nathanshaw/Moth/README.md

# Speculator
This repo holds all the code, schematics, and PCB layouts for all series of the Speculator bot.
