nathanshaw/Moth/PCB/v2/v2_images/v2_both_no_pour.pdf

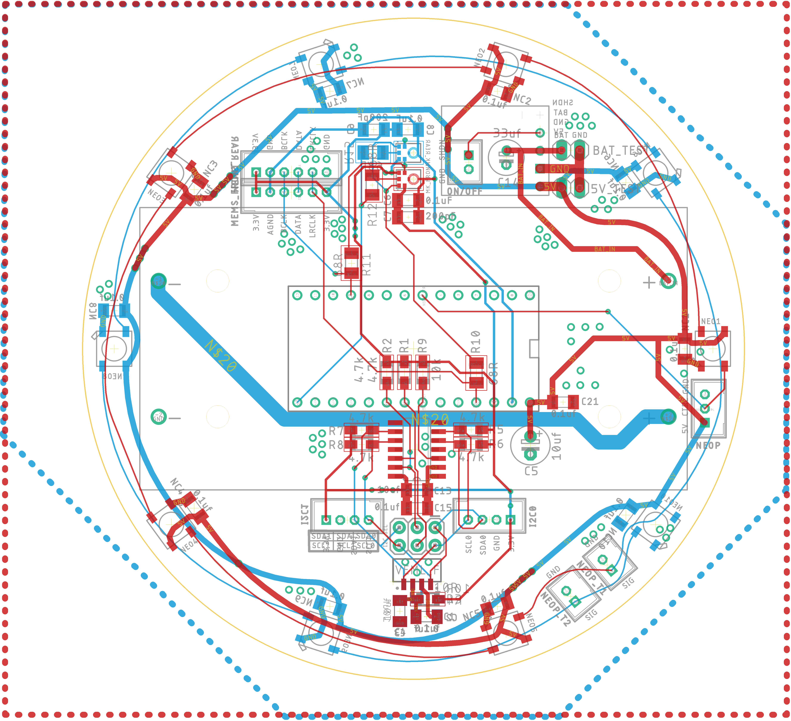
[picture p1: page 1]
