nathanshaw/Moth/PCB/v2/v2_images/v2_both_with_pour.pdf

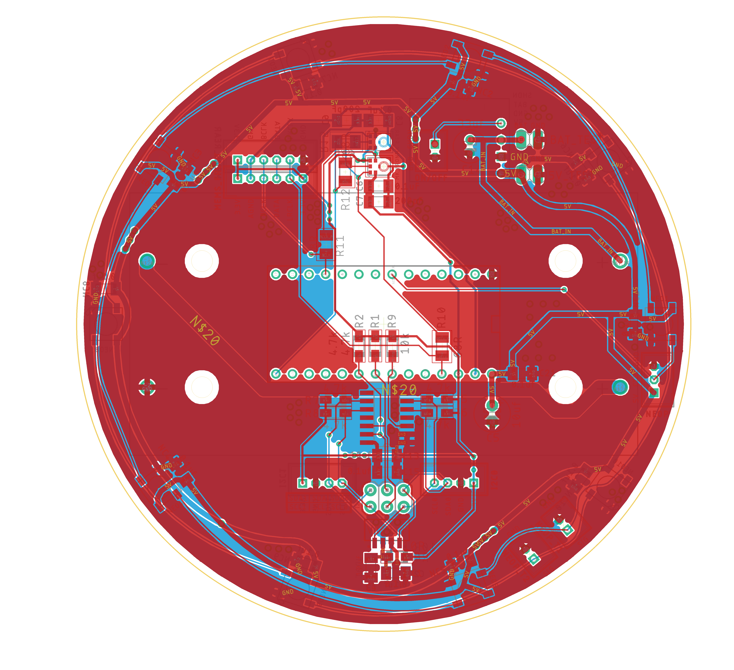
[picture p2: page 1]
