nathanshaw/Moth/PCB/v2/v2_images/v2_bottom_no_pour.pdf

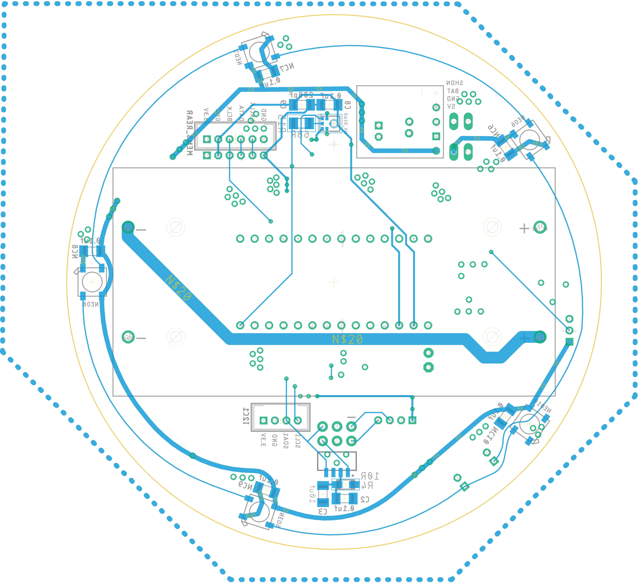
[picture p3: page 1]
