nathanshaw/Moth/PCB/v2/v2_images/v2_bottom_with_pour.pdf

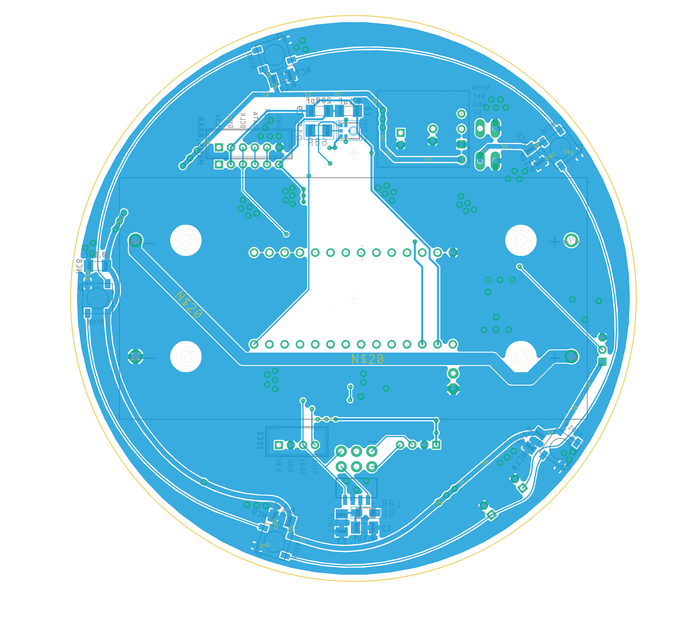
[picture p4: page 1]
