nathanshaw/Moth/PCB/v2/v2_images/v2_top_no_pour.pdf

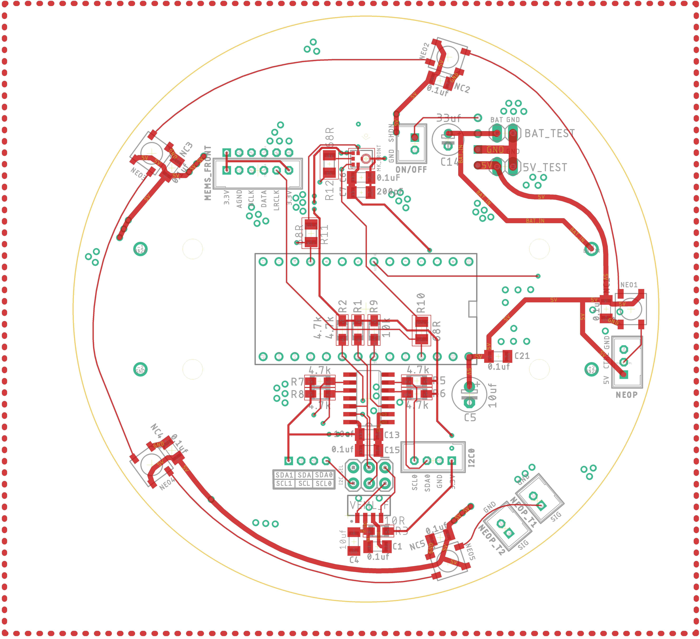
[picture p5: page 1]
