nathanshaw/Moth/PCB/v2/v2_images/v2_top_with_pour.pdf

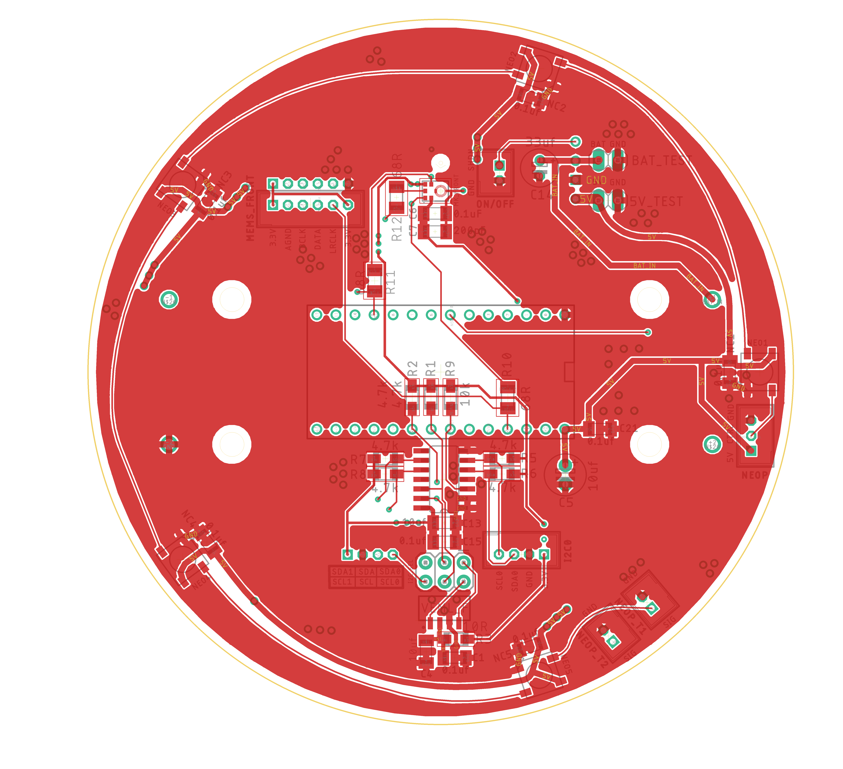
[picture p6: page 1]
