nathanshaw/Moth/PCB/v2_1/v2_1_images/v2_1_both_no_pour.pdf

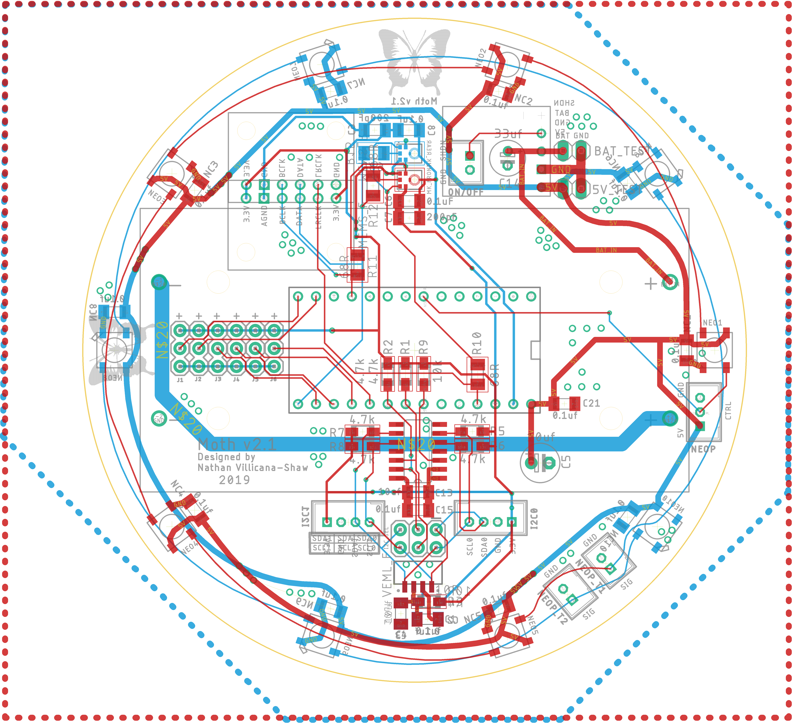
[picture p7: page 1]
