nathanshaw/Moth/PCB/v2_1/v2_1_images/v2_1_both_with_pour.pdf

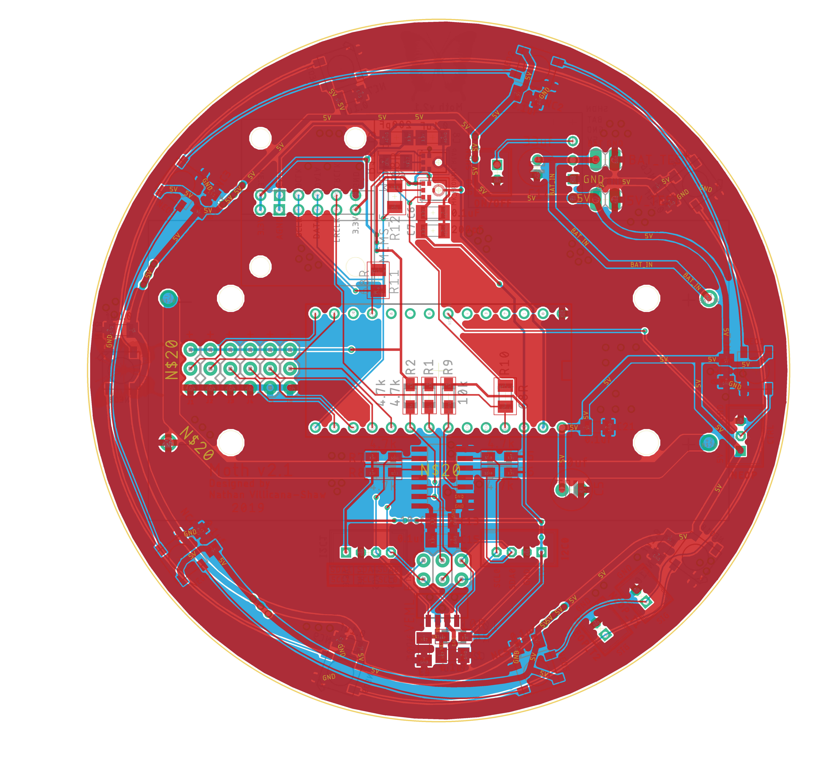
[picture p8: page 1]
