nathanshaw/Moth/PCB/v2_1/v2_1_images/v2_1_bottom_no_pour.pdf

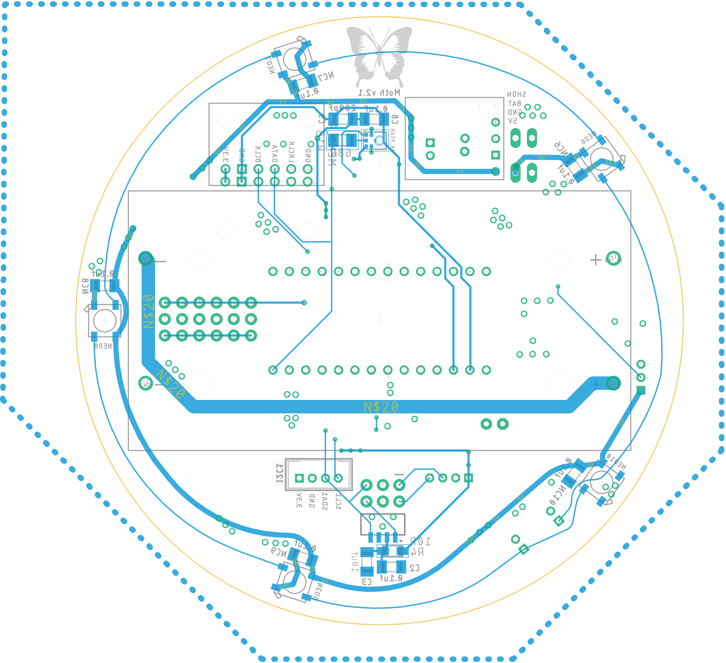
[picture p9: page 1]
