nathanshaw/Moth/PCB/v2_1/v2_1_images/v2_1_bottom_with_pour.pdf

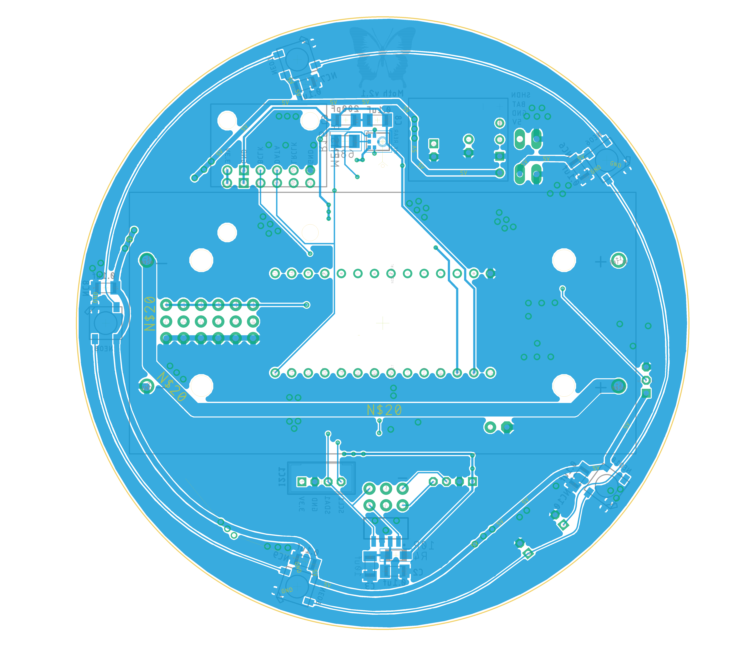
[picture p10: page 1]
