nathanshaw/Moth/PCB/v2_1/v2_1_images/v2_1_top_with_pour.pdf

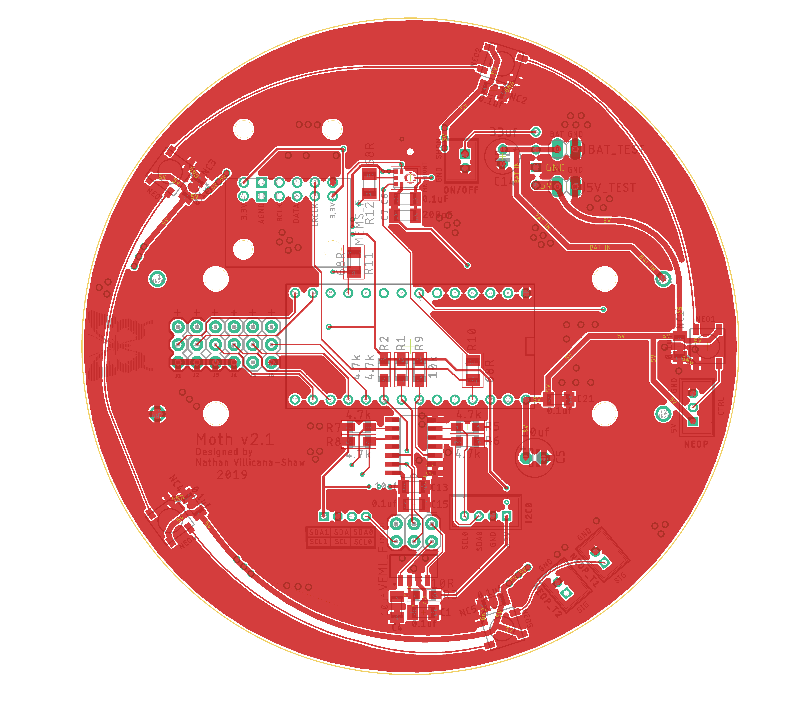
[picture p11: page 1]
