nathanshaw/Moth/PCB/v3/images/54mm/moth_v3_54mm_rear_with_pour.png

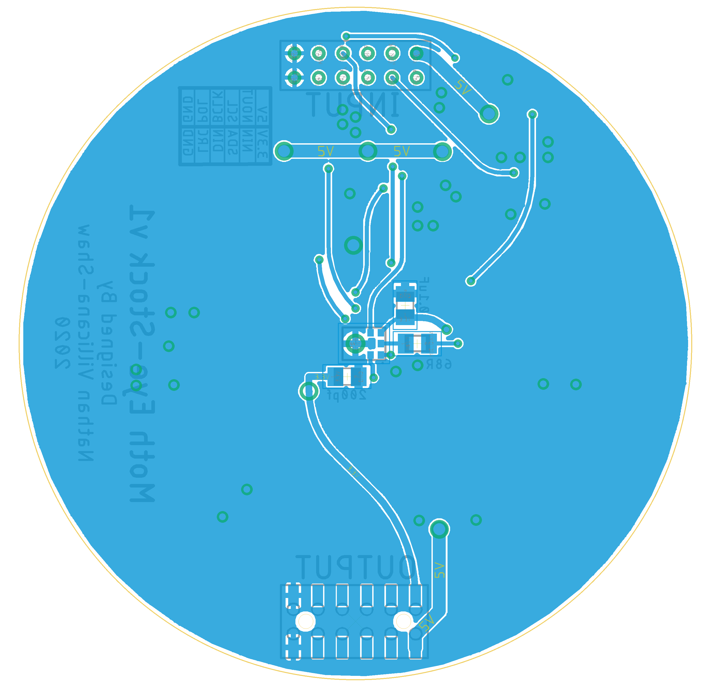
PCB/v3/images/54mm/moth_v3_54mm_rear_with_pour.png
