nathanshaw/Moth/PCB/v3/images/80mm/moth_v3_80mm_both_with_pour.png

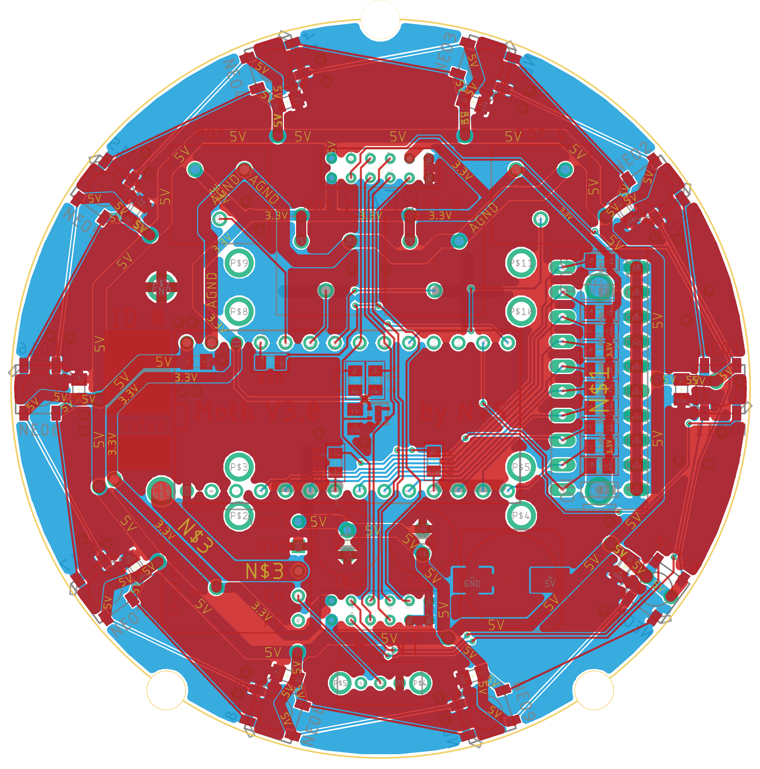
PCB/v3/images/80mm/moth_v3_80mm_both_with_pour.png
