nathanshaw/Moth/PCB/v3/images/80mm/moth_v3_80mm_top_no_pour.png

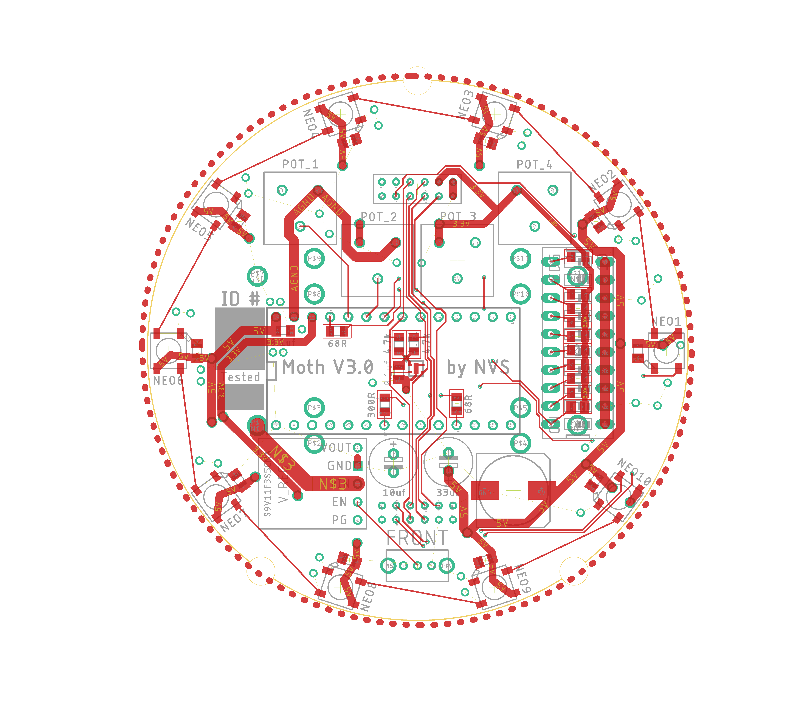
PCB/v3/images/80mm/moth_v3_80mm_top_no_pour.png
