nathanshaw/Moth/PCB/v2_1/moth_v2.1.brd

## EAGLE design PCB/v2_1/moth_v2.1.brd (2020-09-16, an earlier design)

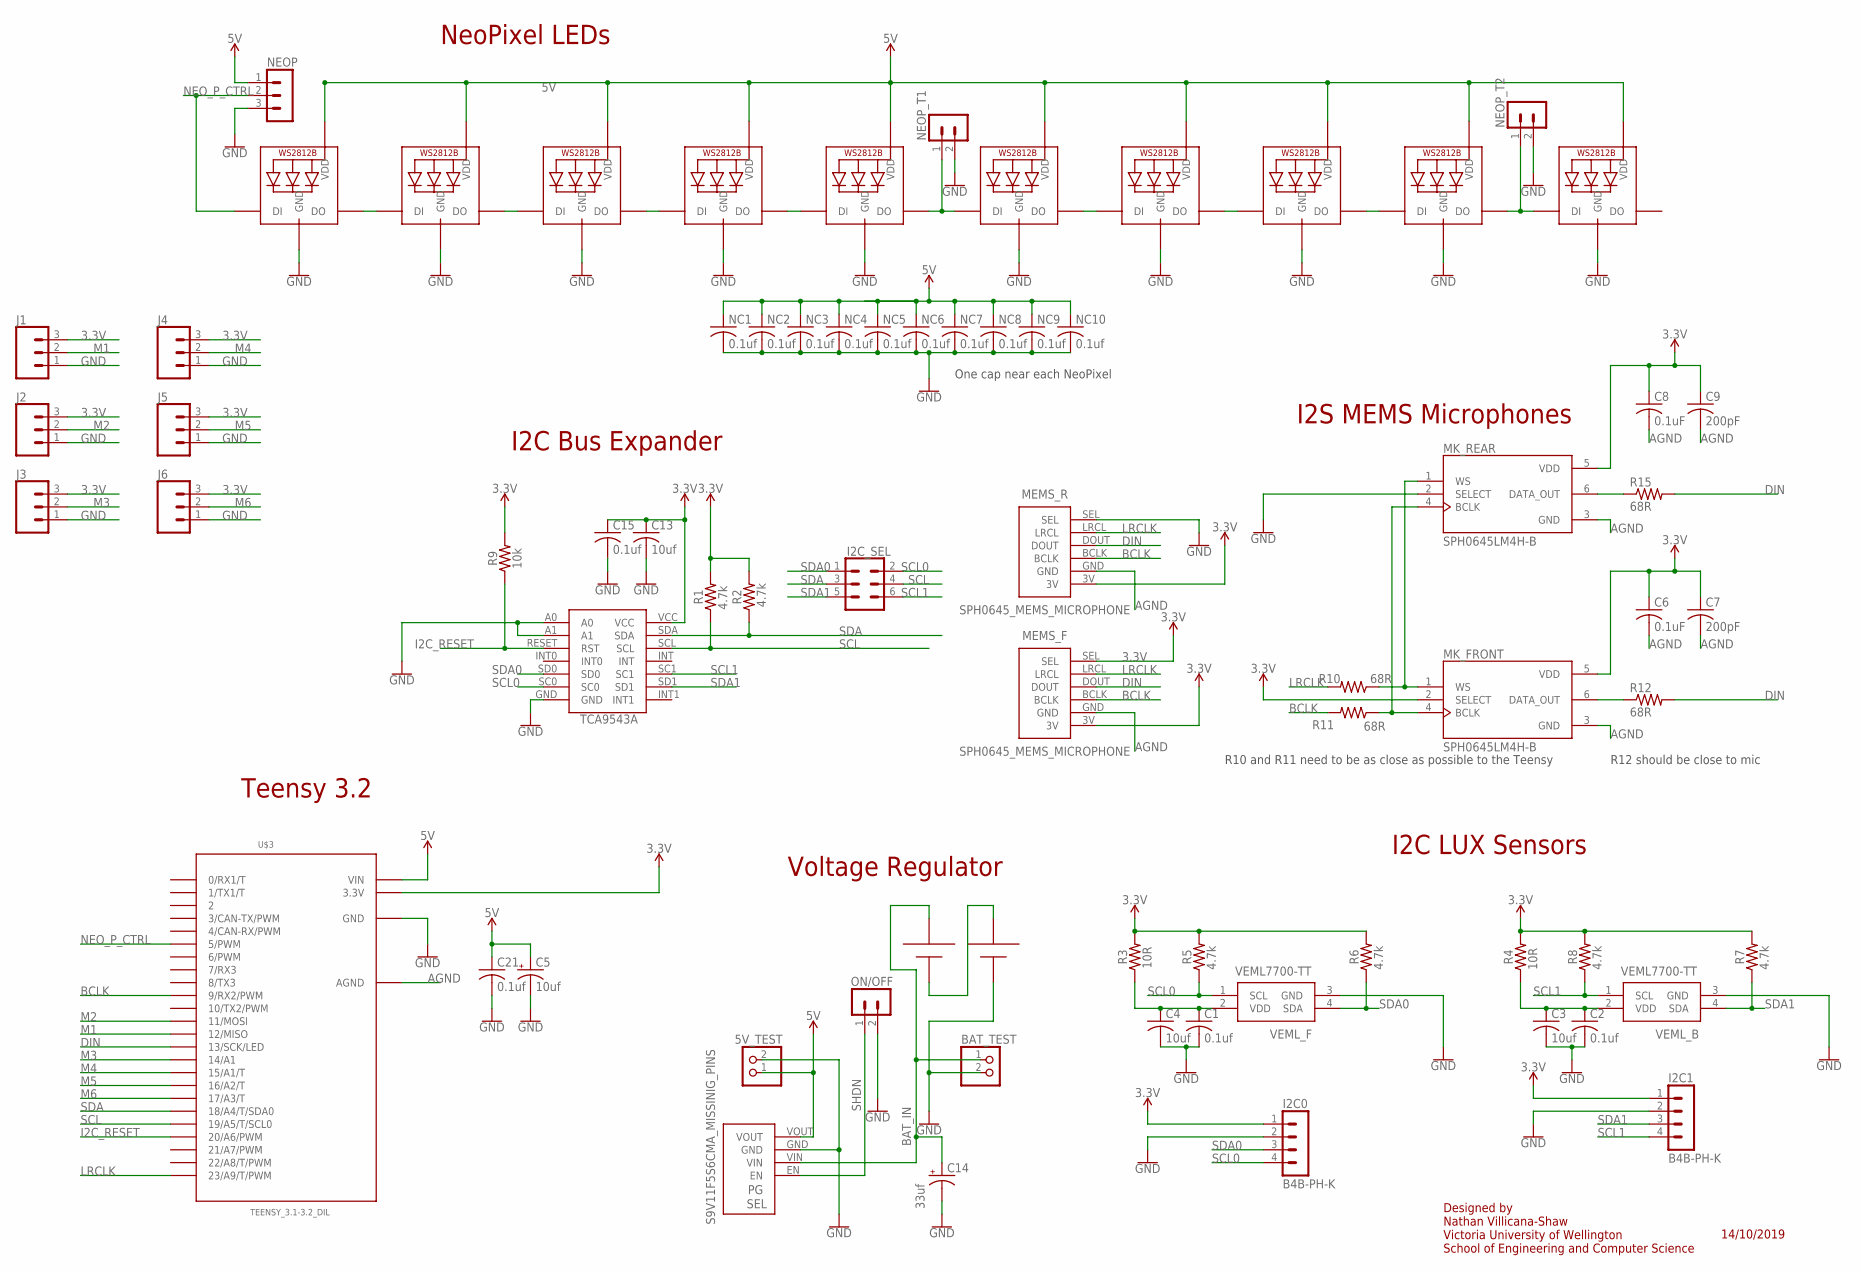
[picture p23: schematic moth_v2.1.sch]

Parts:
5V_TEST: PINHD-1X2; 1X02
BAT_TEST: PINHD-1X2; 1X02
C1, C2, C15, C21: 0.1uf; C1206K
C3, C4, C13: 10uf; C1206K
C5: 10uf; E2,5-6
C6, C8: 0.1uF; C1206K
C7, C9: 200pF; C1206K
C14: 33uf; E2-5
I2C0, I2C1: B4B-PH-K
I2C_SEL: FEMALE 2x3; 2X3
J1, J2, J3, J4, J5, J6: CONN_03; 1X03
MEMS_F: SPH0645_MEMS_MICROPHONE; SPH0645
MEMS_R: SPH0645_MEMS_MICROPHONE; SPH0645
MK_FRONT: SPH0645LM4H-B; MIC_SPH0645LM4H-B
MK_REAR: SPH0645LM4H-B; MIC_SPH0645LM4H-B
NC1, NC2, NC3, NC4, NC5, NC6, NC7, NC8, NC9, NC10: 0.1uf; C1206K
NEO1, NEO2, NEO3, NEO4, NEO5, NEO6, NEO7, NEO8, NEO9, NEO10: WS2812B5050; WS2812B
NEOP: B3B-PH-K
NEOP_T1, NEOP_T2: B2B-PH-K
ON/OFF: B2B-PH-K
R1, R2, R5, R6, R7, R8: 4.7k; R1206W
R3, R4: 10R; R1206W
R9: 10k; R1206W
R10, R11, R12, R15: 68R; M1206
U$1: TCA9543A; SO14
U$2: BK-18650-PC4; 18650-PC4
U$3: TEENSY_3.1-3.2_DIL; TEENSY_3.0-3.2&LC_DIL
U$6: S9V11F5S6CMA_MISSINIG_PINS; S9V11F3S5CMA_MISSING_PINS
VEML_B: VEML7700-TT; VEML7700
VEML_F: VEML7700-TT; VEML7700

Connections:
3.3V: C6.1, C7.1, C8.1, C9.1, C13.1, C15.1, I2C0.1, I2C1.1, J1.3, J2.3, J3.3, J4.3, J5.3, J6.3, MEMS_F.3V, MEMS_F.SEL, MEMS_R.3V, MK_FRONT.2 (SELECT), MK_FRONT.5 (VDD), MK_REAR.5 (VDD), R1.2, R2.2, R3.2, R4.2, R5.2, R6.2, R7.2, R8.2, R9.2, U$1.VCC, U$3.3.3V
5V: 5V_TEST.1, C5.+, C21.1, NC1.1, NC2.1, NC3.1, NC4.1, NC5.1, NC6.1, NC7.1, NC8.1, NC9.1, NC10.1, NEO1.1-VDD (VDD), NEO2.1-VDD (VDD), NEO3.1-VDD (VDD), NEO4.1-VDD (VDD), NEO5.1-VDD (VDD), NEO6.1-VDD (VDD), NEO7.1-VDD (VDD), NEO8.1-VDD (VDD), NEO9.1-VDD (VDD), NEO10.1-VDD (VDD), NEOP.1, U$3.VIN, U$6.VOUT
AGND: C6.2, C7.2, C8.2, C9.2, MEMS_F.GND, MEMS_R.GND, MK_FRONT.3 (GND), MK_REAR.3 (GND), U$3.AGND
BAT_IN: BAT_TEST.1, C14.+, U$2.+1, U$6.VIN
BCLK: MEMS_F.BCLK, MEMS_R.BCLK, R11.2, U$3.9 (9/RX2/PWM)
BCLK_P: MK_FRONT.4 (BCLK), MK_REAR.4 (BCLK), R11.1
DIN: MEMS_F.DOUT, MEMS_R.DOUT, R12.2, R15.2, U$3.13 (13/SCK/LED)
GND: 5V_TEST.2, BAT_TEST.2, C1.2, C2.2, C3.2, C4.2, C5.-, C13.2, C14.-, C15.2, C21.2, I2C0.2, I2C1.2, J1.1, J2.1, J3.1, J4.1, J5.1, J6.1, MEMS_R.SEL, MK_REAR.2 (SELECT), NC1.2, NC2.2, NC3.2, NC4.2, NC5.2, NC6.2, NC7.2, NC8.2, NC9.2, NC10.2, NEO1.3-GND (GND), NEO2.3-GND (GND), NEO3.3-GND (GND), NEO4.3-GND (GND), NEO5.3-GND (GND), NEO6.3-GND (GND), NEO7.3-GND (GND), NEO8.3-GND (GND), NEO9.3-GND (GND), NEO10.3-GND (GND), NEOP.3, NEOP_T1.2, NEOP_T2.2, ON/OFF.2, U$1.A0, U$1.A1, U$1.GND, U$2.-2, U$3.GND, U$6.GND, VEML_B.3 (GND), VEML_F.3 (GND)
I2C_RESET: R9.1, U$1.RESET (RST), U$3.20/A6 (20/A6/PWM)
LRCLK: MEMS_F.LRCL, MEMS_R.LRCL, R10.2, U$3.23/A9 (23/A9/T/PWM)
LRCLK_P: MK_FRONT.1 (WS), MK_REAR.1 (WS), R10.1
M1: J1.2, U$3.12 (12/MISO)
M2: J2.2, U$3.11 (11/MOSI)
M3: J3.2, U$3.14/A0 (14/A1)
M4: J4.2, U$3.15/A1 (15/A1/T)
M5: J5.2, U$3.16/A2 (16/A2/T)
M6: J6.2, U$3.17/A3 (17/A3/T)
unnamed: C1.1, C4.1, R3.1, VEML_F.2 (VDD)
unnamed: C2.1, C3.1, R4.1, VEML_B.2 (VDD)
unnamed: MK_FRONT.6 (DATA_OUT), R12.1
unnamed: NEO2.2-DOUT (DO), NEO3.4-DIN (DI)
unnamed: NEO5.2-DOUT (DO), NEO6.4-DIN (DI), NEOP_T1.1
unnamed: NEO9.2-DOUT (DO), NEO10.4-DIN (DI), NEOP_T2.1
unnamed: NEO4.2-DOUT (DO), NEO5.4-DIN (DI)
unnamed: NEO3.2-DOUT (DO), NEO4.4-DIN (DI)
unnamed: NEO7.2-DOUT (DO), NEO8.4-DIN (DI)
unnamed: NEO8.2-DOUT (DO), NEO9.4-DIN (DI)
unnamed: MK_REAR.6 (DATA_OUT), R15.1
unnamed: U$2.+2, U$2.-1
unnamed: NEO6.2-DOUT (DO), NEO7.4-DIN (DI)
NEO_P1: NEO1.2-DOUT (DO), NEO2.4-DIN (DI)
NEO_P_CTRL: NEO1.4-DIN (DI), NEOP.2, U$3.5 (5/PWM)
SCL: I2C_SEL.4, R1.1, U$1.SCL, U$3.19/A5 (19/A5/T/SCL0)
SCL0: I2C0.4, I2C_SEL.2, R5.1, U$1.SC0, VEML_F.1 (SCL)
SCL1: I2C1.4, I2C_SEL.6, R8.1, U$1.SC1, VEML_B.1 (SCL)
SDA: I2C_SEL.3, R2.1, U$1.SDA, U$3.18/A4 (18/A4/T/SDA0)
SDA0: I2C0.3, I2C_SEL.1, R6.1, U$1.SD0, VEML_F.4 (SDA)
SDA1: I2C1.3, I2C_SEL.5, R7.1, U$1.SD1, VEML_B.4 (SDA)
SHDN: ON/OFF.1, U$6.EN

Notes on the sheet:
I2S MEMS Microphones
Voltage Regulator
I2C LUX Sensors
I2C Bus Expander
NeoPixel LEDs
10k
4.7k
One cap near each NeoPixel
R10 and R11 need to be as close as possible to the Teensy
R12 should be close to mic
10R
Teensy 3.2
Designed by Nathan Villicana-Shaw Victoria University of Wellington School of Engineering and Computer Science
14/10/2019

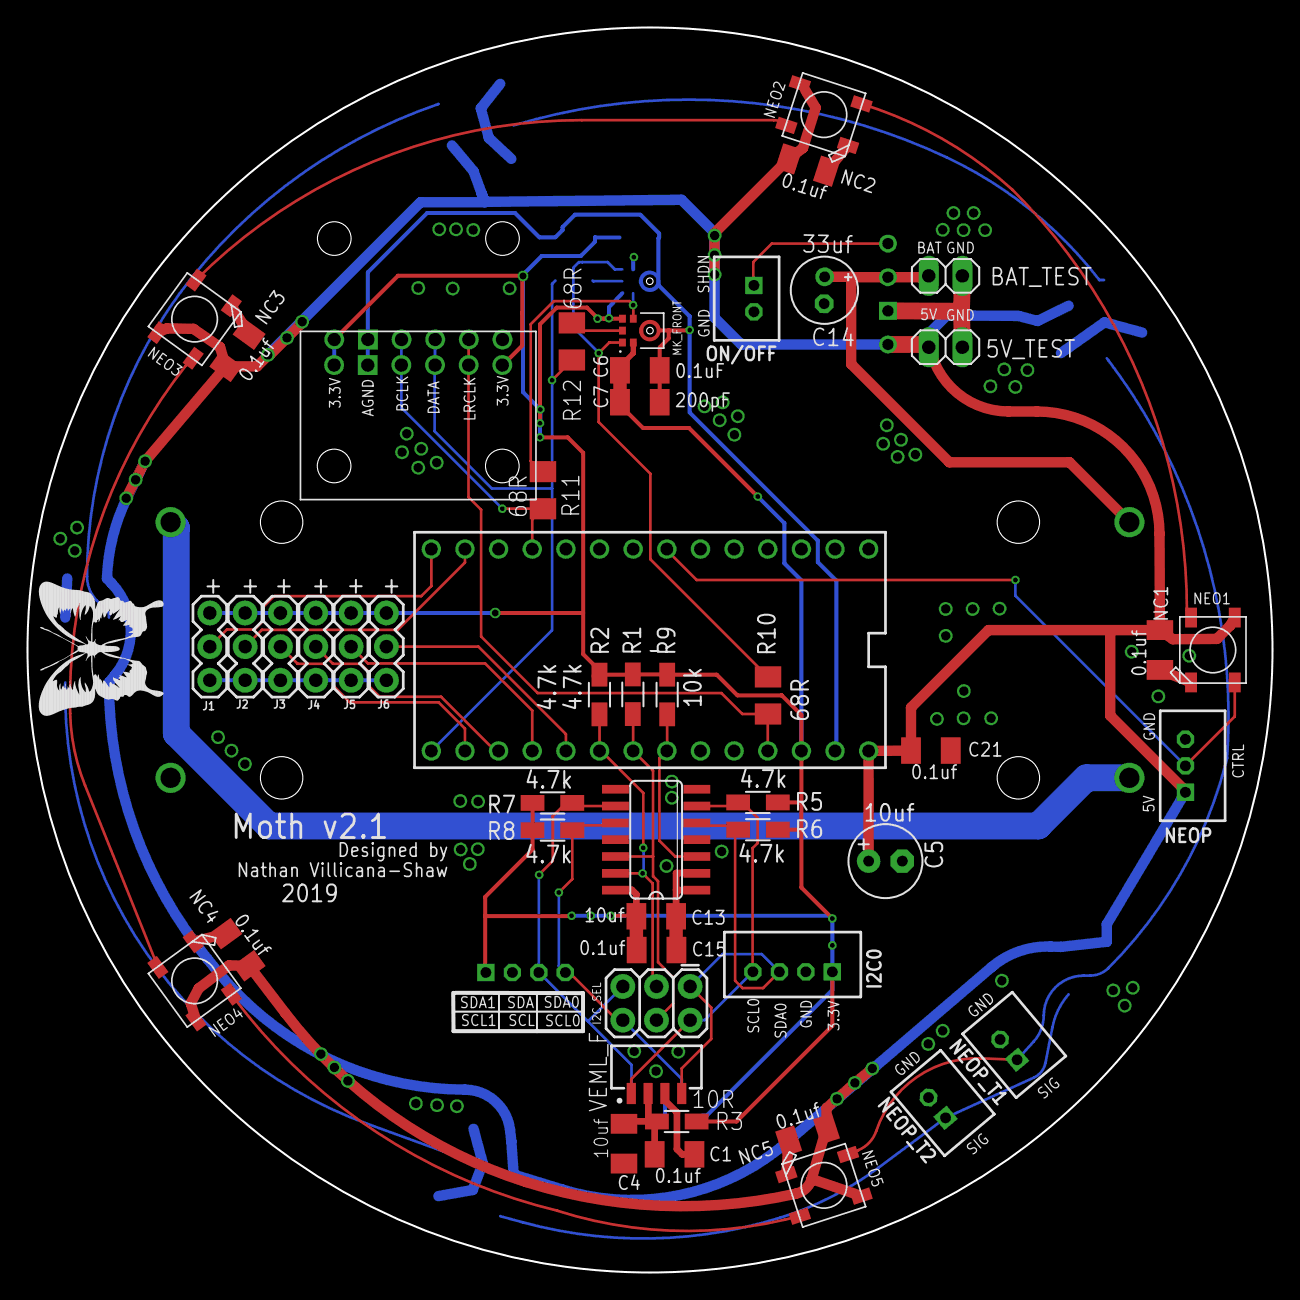
[picture p24: board moth_v2.1.brd from above]

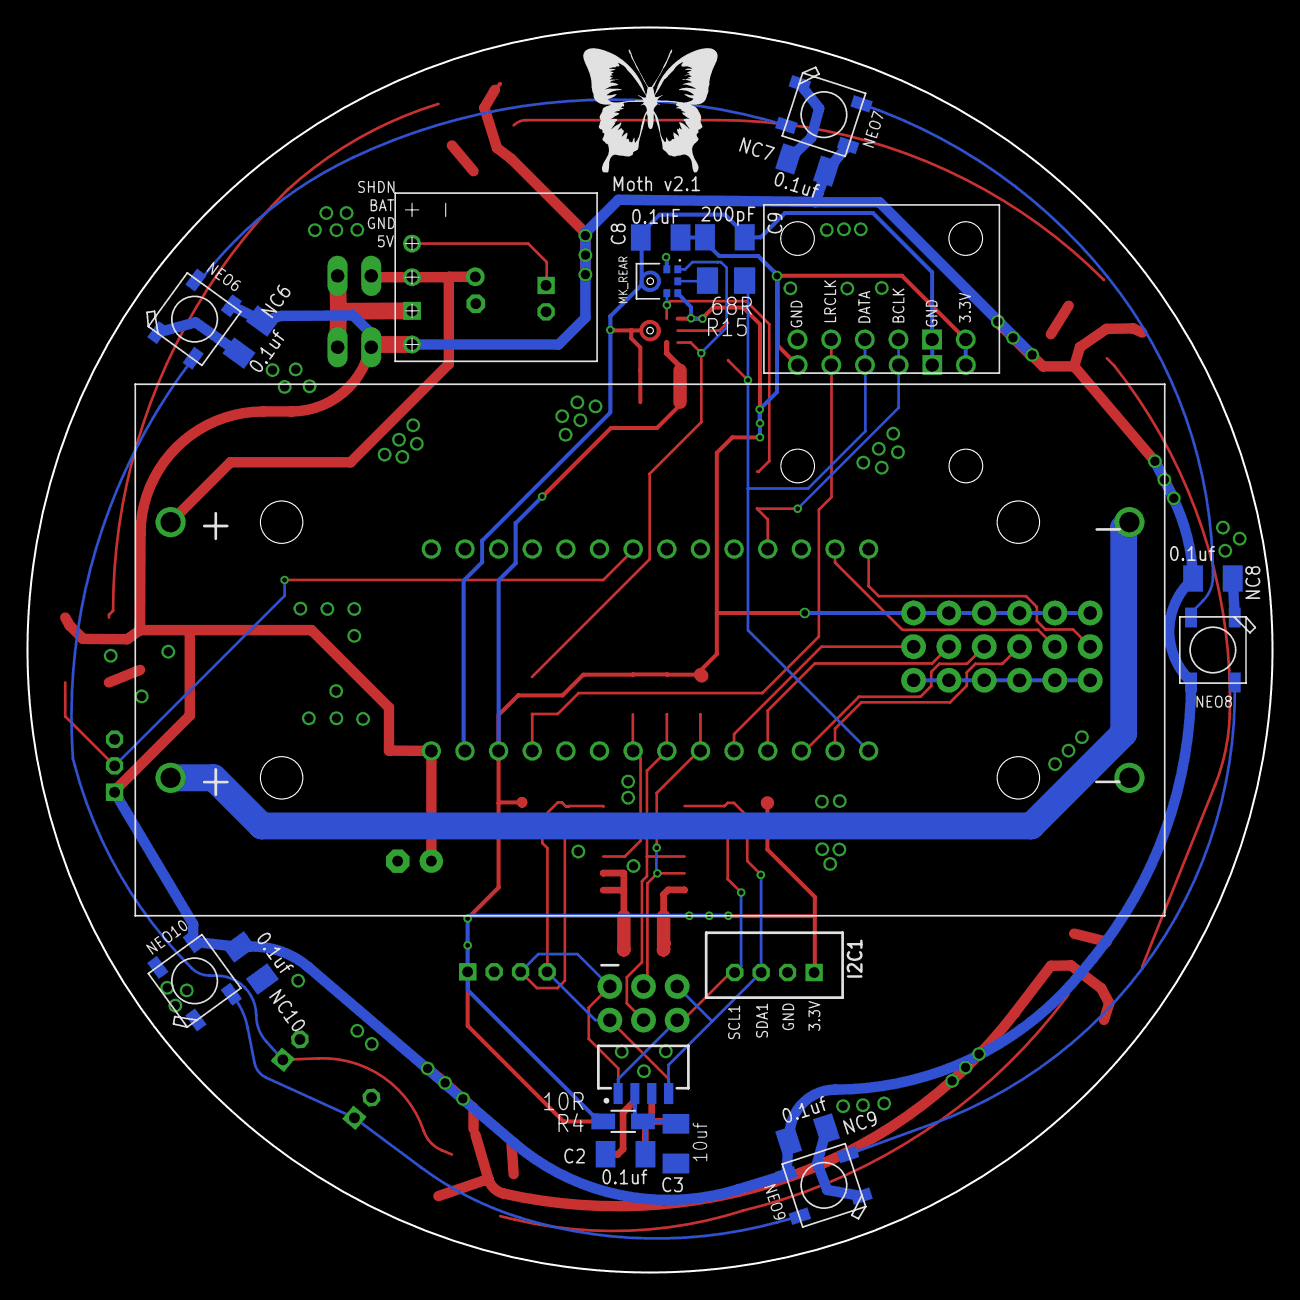
[picture p25: board moth_v2.1.brd from below]

Board: 2 copper layers, 94.0 x 94.0 mm, 71 parts (22 on the bottom side), 39 nets.
