nathanshaw/Moth/PCB/v3/moth_v3_80mm_main_board.brd

## EAGLE design PCB/v3/moth_v3_80mm_main_board.brd (2020-06-29)

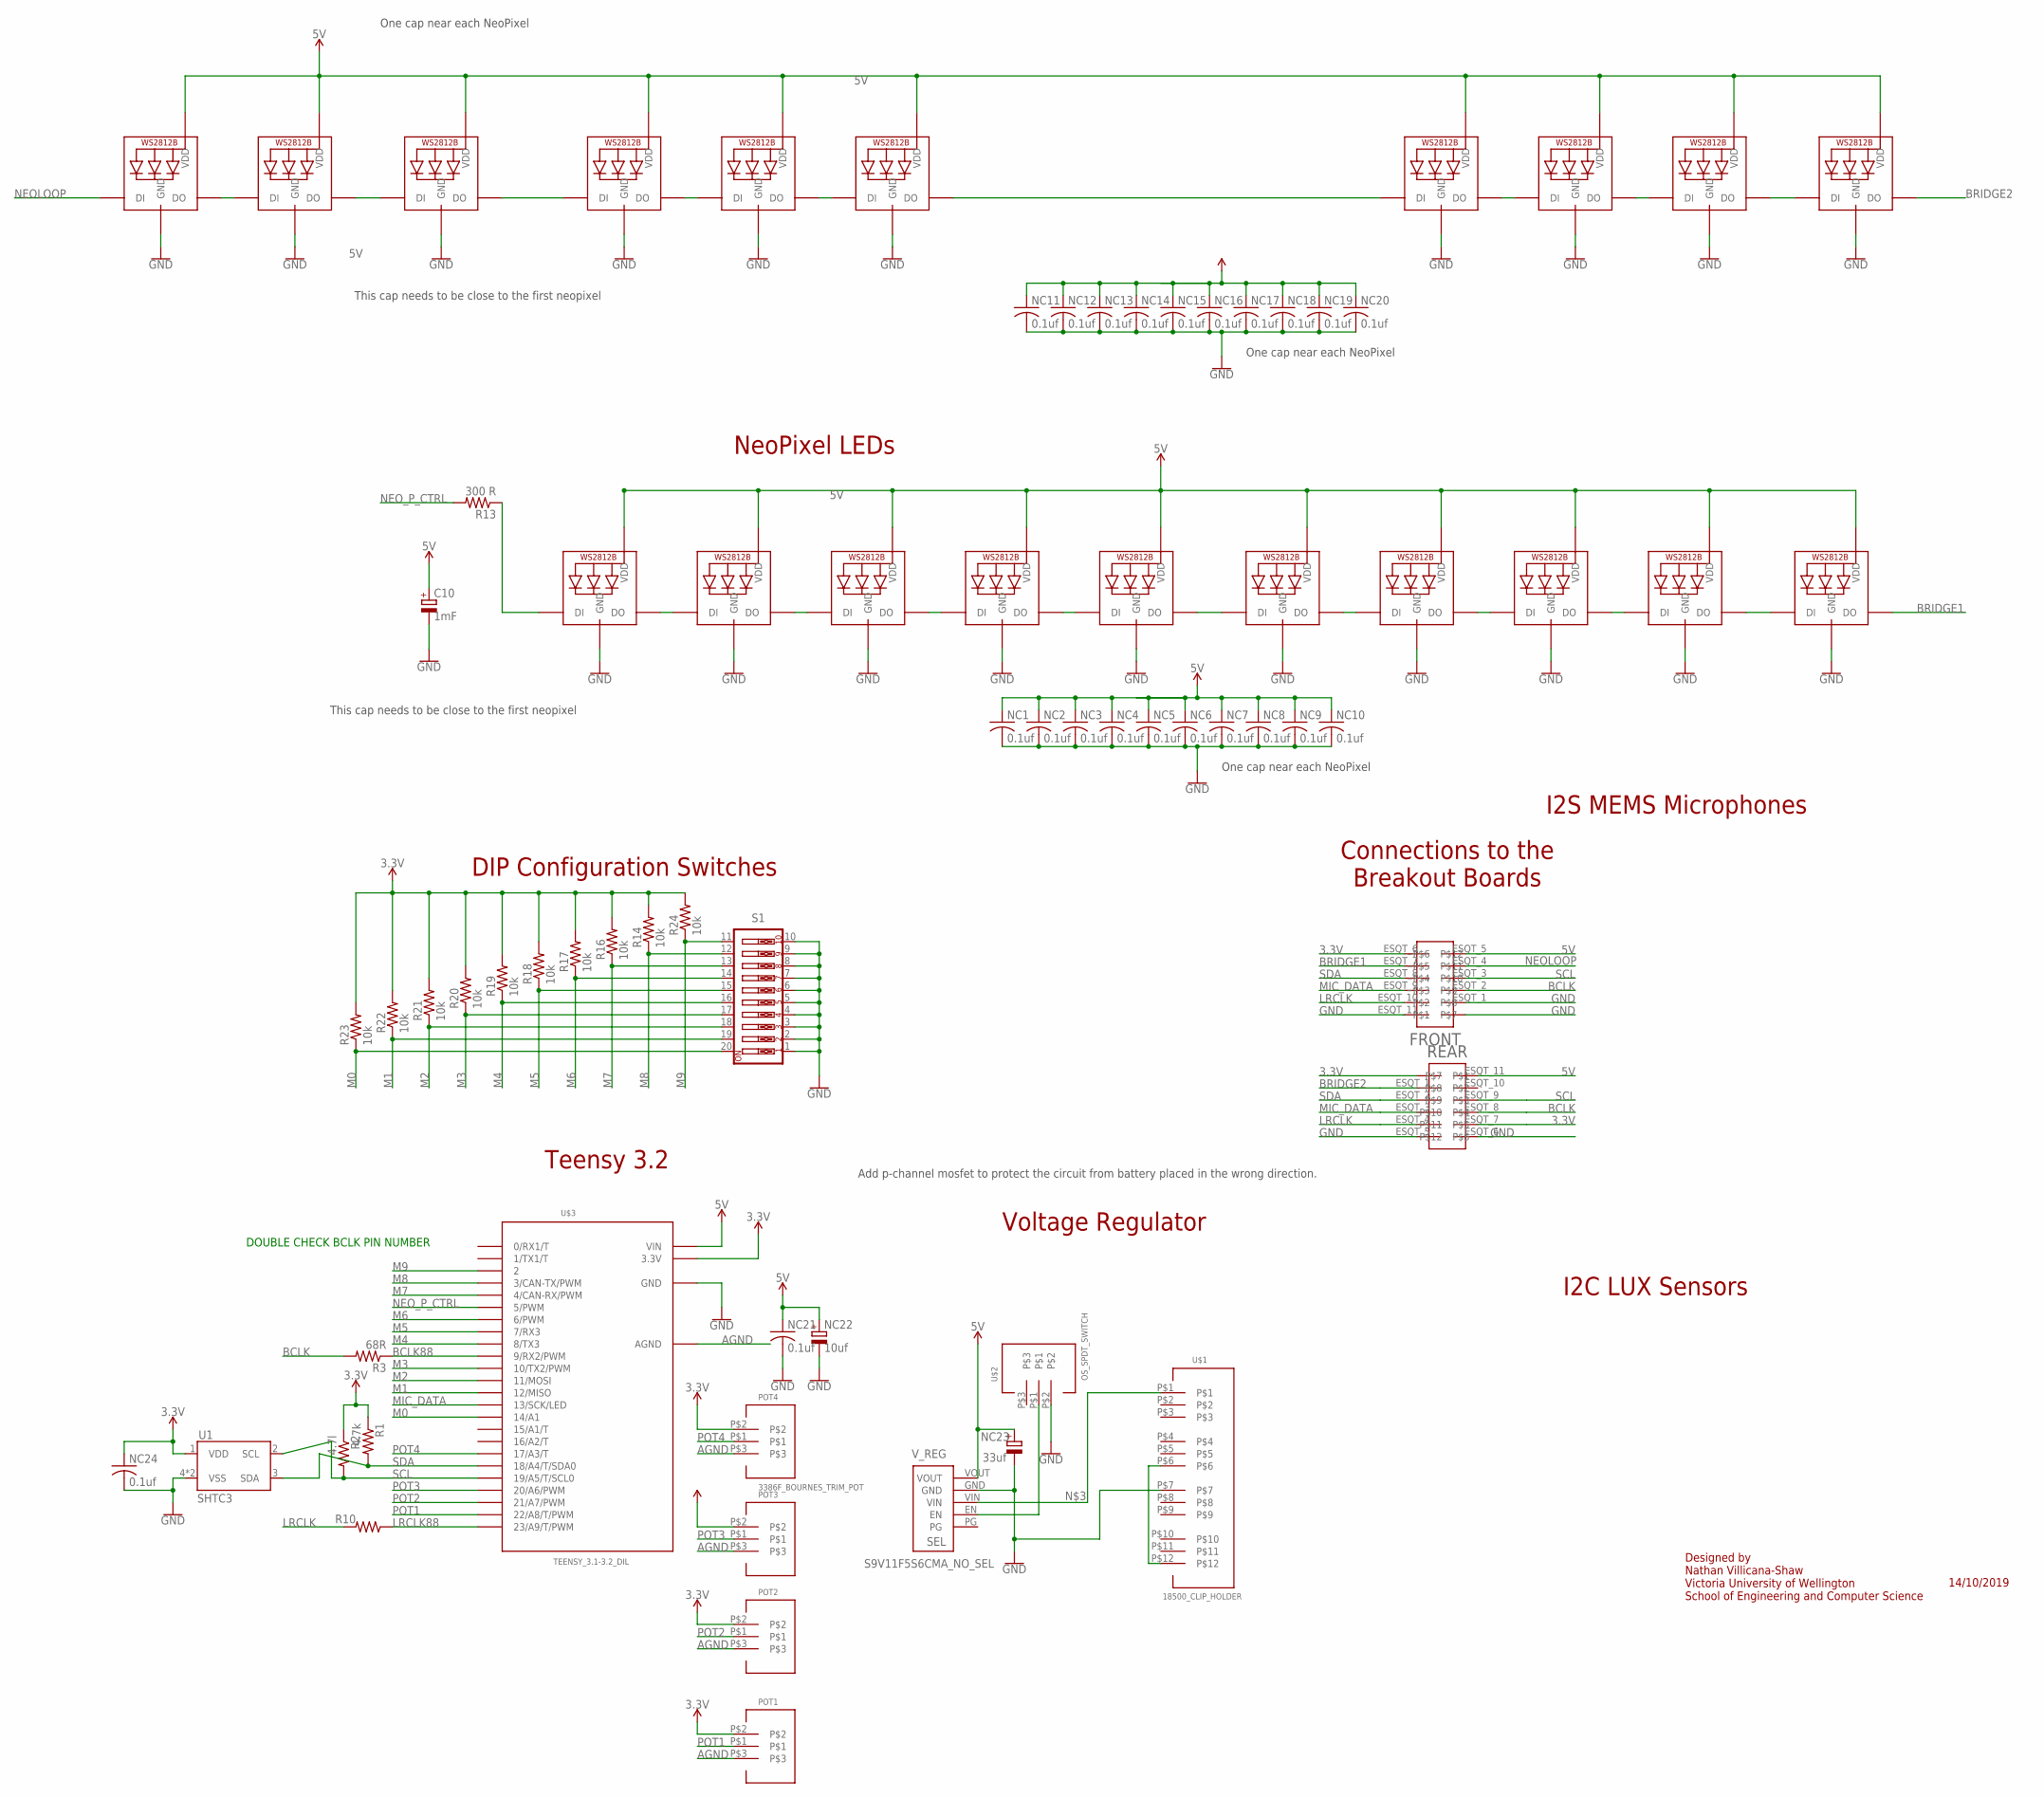
[picture p26: schematic moth_v3_80mm_main_board.sch]

Parts:
C10: 1mF; 153CLV-1010
FRONT: SAMTEC_ESQT_2X6_THROUGH_HOLE
NC1, NC2, NC3, NC4, NC5, NC6, NC7, NC8, NC9, NC10, NC11, NC12, NC13, NC14, NC15, NC16, NC17, NC18, NC19, NC20, NC21, NC24: 0.1uf; C0805K
NC22: 10uf; E2,5-7
NC23: 33uf; E2,5-7
NEO1, NEO2, NEO3, NEO4, NEO5, NEO6, NEO7, NEO8, NEO9, NEO10, NEO11, NEO12, NEO13, NEO14, NEO15, NEO16, NEO17, NEO18, NEO19, NEO20: WS2812B5050; WS2812B
POT1, POT2, POT3, POT4: 3386F_BOURNES_TRIM_POT; 3386_BOURNS_TRIM_POT
R1: 4.7k; R0805
R2: 4.7l; R0805
R3, R10: 68R; R0805
R13: 300 R; R0805
R14, R16, R17, R18, R19, R20, R21, R22, R24: 10k; R0805
R23: 10k; M0805
REAR: SAMTEC_ESQT_2X6_THROUGH_HOLE
S1: SW_DIP-10; EDG-10
U1: SHTC3
U$1: 18500_CLIP_HOLDER; 3PINBATTERY_CLIP
U$2: OS_SPDT_SWITCH; OS_SPDT_SLIDE_SWITCH
U$3: TEENSY_3.1-3.2_DIL; TEENSY_3.0-3.2&LC_DIL
V_REG: S9V11F5S6CMA_NO_SEL; S9V11F3S5CMA_NO_SEL

Connections:
3.3V: FRONT.ESQT_6, NC24.1, POT1.P$2, POT2.P$2, POT3.P$2, POT4.P$2, R1.1, R2.1, R14.2, R16.2, R17.2, R18.2, R19.2, R20.2, R21.2, R22.2, R23.2, R24.2, REAR.ESQT_0, REAR.ESQT_7, U1.1 (VDD), U$3.3.3V
5V: C10.+, FRONT.ESQT_5, NC1.1, NC2.1, NC3.1, NC4.1, NC5.1, NC6.1, NC7.1, NC8.1, NC9.1, NC10.1, NC11.1, NC12.1, NC13.1, NC14.1, NC15.1, NC16.1, NC17.1, NC18.1, NC19.1, NC20.1, NC21.1, NC22.+, NC23.+, NEO1.1-VDD (VDD), NEO2.1-VDD (VDD), NEO3.1-VDD (VDD), NEO4.1-VDD (VDD), NEO5.1-VDD (VDD), NEO6.1-VDD (VDD), NEO7.1-VDD (VDD), NEO8.1-VDD (VDD), NEO9.1-VDD (VDD), NEO10.1-VDD (VDD), NEO11.1-VDD (VDD), NEO12.1-VDD (VDD), NEO13.1-VDD (VDD), NEO14.1-VDD (VDD), NEO15.1-VDD (VDD), NEO16.1-VDD (VDD), NEO17.1-VDD (VDD), NEO18.1-VDD (VDD), NEO19.1-VDD (VDD), NEO20.1-VDD (VDD), REAR.ESQT_11, U$3.VIN, V_REG.VOUT
AGND: POT1.P$3, POT2.P$3, POT3.P$3, POT4.P$3, U$3.AGND
BCLK: FRONT.ESQT_2, R3.2, REAR.ESQT_8
BCLK88: R3.1, U$3.9 (9/RX2/PWM)
BRIDGE1: FRONT.ESQT_7, NEO10.2-DOUT (DO)
BRIDGE2: NEO20.2-DOUT (DO), REAR.ESQT_1
GND: C10.-, FRONT.ESQT_0, FRONT.ESQT_1, FRONT.ESQT_11, NC1.2, NC2.2, NC3.2, NC4.2, NC5.2, NC6.2, NC7.2, NC8.2, NC9.2, NC10.2, NC11.2, NC12.2, NC13.2, NC14.2, NC15.2, NC16.2, NC17.2, NC18.2, NC19.2, NC20.2, NC21.2, NC22.-, NC23.-, NC24.2, NEO1.3-GND (GND), NEO2.3-GND (GND), NEO3.3-GND (GND), NEO4.3-GND (GND), NEO5.3-GND (GND), NEO6.3-GND (GND), NEO7.3-GND (GND), NEO8.3-GND (GND), NEO9.3-GND (GND), NEO10.3-GND (GND), NEO11.3-GND (GND), NEO12.3-GND (GND), NEO13.3-GND (GND), NEO14.3-GND (GND), NEO15.3-GND (GND), NEO16.3-GND (GND), NEO17.3-GND (GND), NEO18.3-GND (GND), NEO19.3-GND (GND), NEO20.3-GND (GND), REAR.ESQT_5, REAR.ESQT_6, S1.1, S1.2, S1.3, S1.4, S1.5, S1.6, S1.7, S1.8, S1.9, S1.10, U1.4 (VSS), U1.5 (VSS), U$1.P$7, U$2.P$2, U$3.GND, V_REG.GND
LRCLK: FRONT.ESQT_10, R10.2, REAR.ESQT_4
LRCLK88: R10.1, U$3.23/A9 (23/A9/T/PWM)
M0: R23.1, S1.20, U$3.14/A0 (14/A1)
M1: R22.1, S1.19, U$3.12 (12/MISO)
M2: R21.1, S1.18, U$3.11 (11/MOSI)
M3: R20.1, S1.17, U$3.10 (10/TX2/PWM)
M4: R19.1, S1.16, U$3.8 (8/TX3)
M5: R18.1, S1.15, U$3.7 (7/RX3)
M6: R17.1, S1.14, U$3.6 (6/PWM)
M7: R16.1, S1.13, U$3.4 (4/CAN-RX/PWM)
M8: R14.1, S1.12, U$3.3 (3/CAN-TX/PWM)
M9: R24.1, S1.11, U$3.2
MIC_DATA: FRONT.ESQT_9, REAR.ESQT_3, U$3.13 (13/SCK/LED)
unnamed: U$1.P$6, U$1.P$12
unnamed: U$1.P$1, V_REG.VIN
unnamed: NEO2.2-DOUT (DO), NEO3.4-DIN (DI)
unnamed: NEO5.2-DOUT (DO), NEO6.4-DIN (DI)
unnamed: NEO9.2-DOUT (DO), NEO10.4-DIN (DI)
unnamed: NEO11.2-DOUT (DO), NEO12.4-DIN (DI)
unnamed: NEO4.2-DOUT (DO), NEO5.4-DIN (DI)
unnamed: NEO15.2-DOUT (DO), NEO16.4-DIN (DI)
unnamed: NEO3.2-DOUT (DO), NEO4.4-DIN (DI)
unnamed: NEO7.2-DOUT (DO), NEO8.4-DIN (DI)
unnamed: NEO8.2-DOUT (DO), NEO9.4-DIN (DI)
unnamed: NEO18.2-DOUT (DO), NEO19.4-DIN (DI)
unnamed: NEO13.2-DOUT (DO), NEO14.4-DIN (DI)
unnamed: NEO16.2-DOUT (DO), NEO17.4-DIN (DI)
unnamed: NEO12.2-DOUT (DO), NEO13.4-DIN (DI)
unnamed: NEO19.2-DOUT (DO), NEO20.4-DIN (DI)
unnamed: NEO6.2-DOUT (DO), NEO7.4-DIN (DI)
unnamed: NEO17.2-DOUT (DO), NEO18.4-DIN (DI)
NEOLOOP: FRONT.ESQT_4, NEO11.4-DIN (DI)
NEO_P1: NEO1.2-DOUT (DO), NEO2.4-DIN (DI)
NEO_P2: NEO14.2-DOUT (DO), NEO15.4-DIN (DI)
NEO_P_CTRL: R13.2, U$3.5 (5/PWM)
NEO_P_CTRL_INT: NEO1.4-DIN (DI), R13.1
POT1: POT1.P$1, U$3.22/A8 (22/A8/T/PWM)
POT2: POT2.P$1, U$3.21/A7 (21/A7/PWM)
POT3: POT3.P$1, U$3.20/A6 (20/A6/PWM)
POT4: POT4.P$1, U$3.17/A3 (17/A3/T)
SCL: FRONT.ESQT_3, R2.2, REAR.ESQT_9, U1.2 (SCL), U$3.19/A5 (19/A5/T/SCL0)
SDA: FRONT.ESQT_8, R1.2, REAR.ESQT_2, U1.3 (SDA), U$3.18/A4 (18/A4/T/SDA0)
SHDN: U$2.P$1, V_REG.EN

Notes on the sheet:
I2S MEMS Microphones
Voltage Regulator
I2C LUX Sensors
NeoPixel LEDs
One cap near each NeoPixel
Teensy 3.2
Designed by Nathan Villicana-Shaw Victoria University of Wellington School of Engineering and Computer Science
14/10/2019
DIP Configuration Switches
This cap needs to be close to the first neopixel
Add p-channel mosfet to protect the circuit from battery placed in the wrong direction.
Connections to the Breakout Boards
DOUBLE CHECK BCLK PIN NUMBER

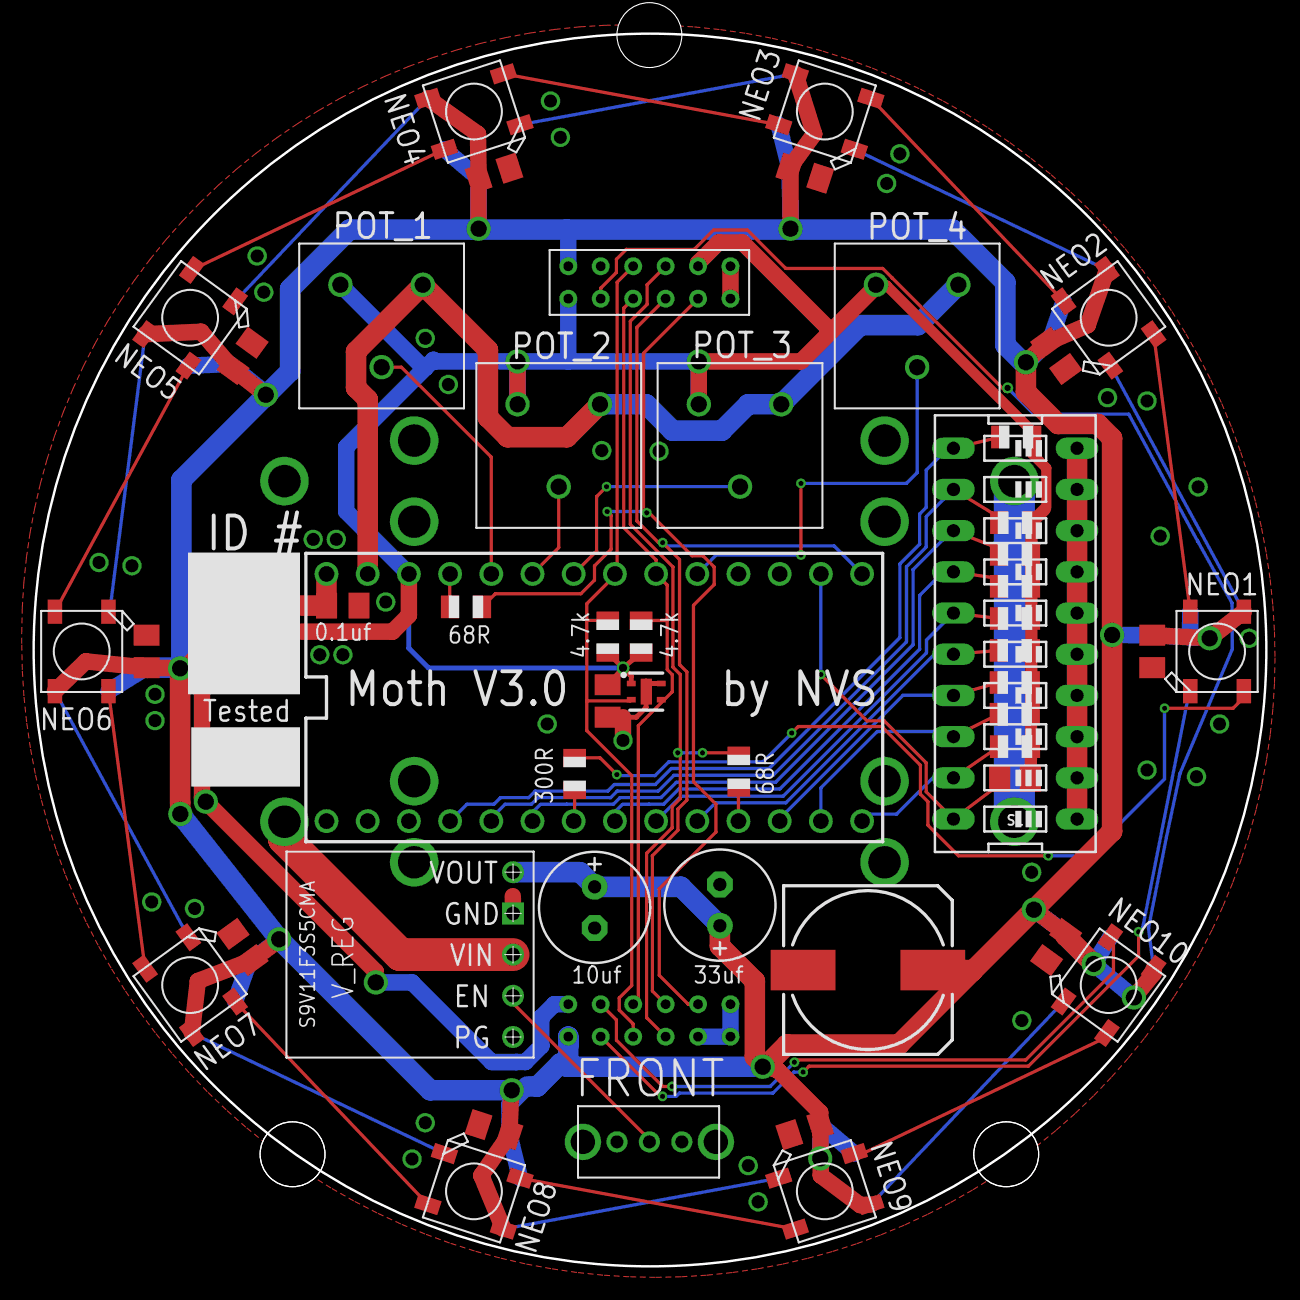
[picture p27: board moth_v3_80mm_main_board.brd from above]

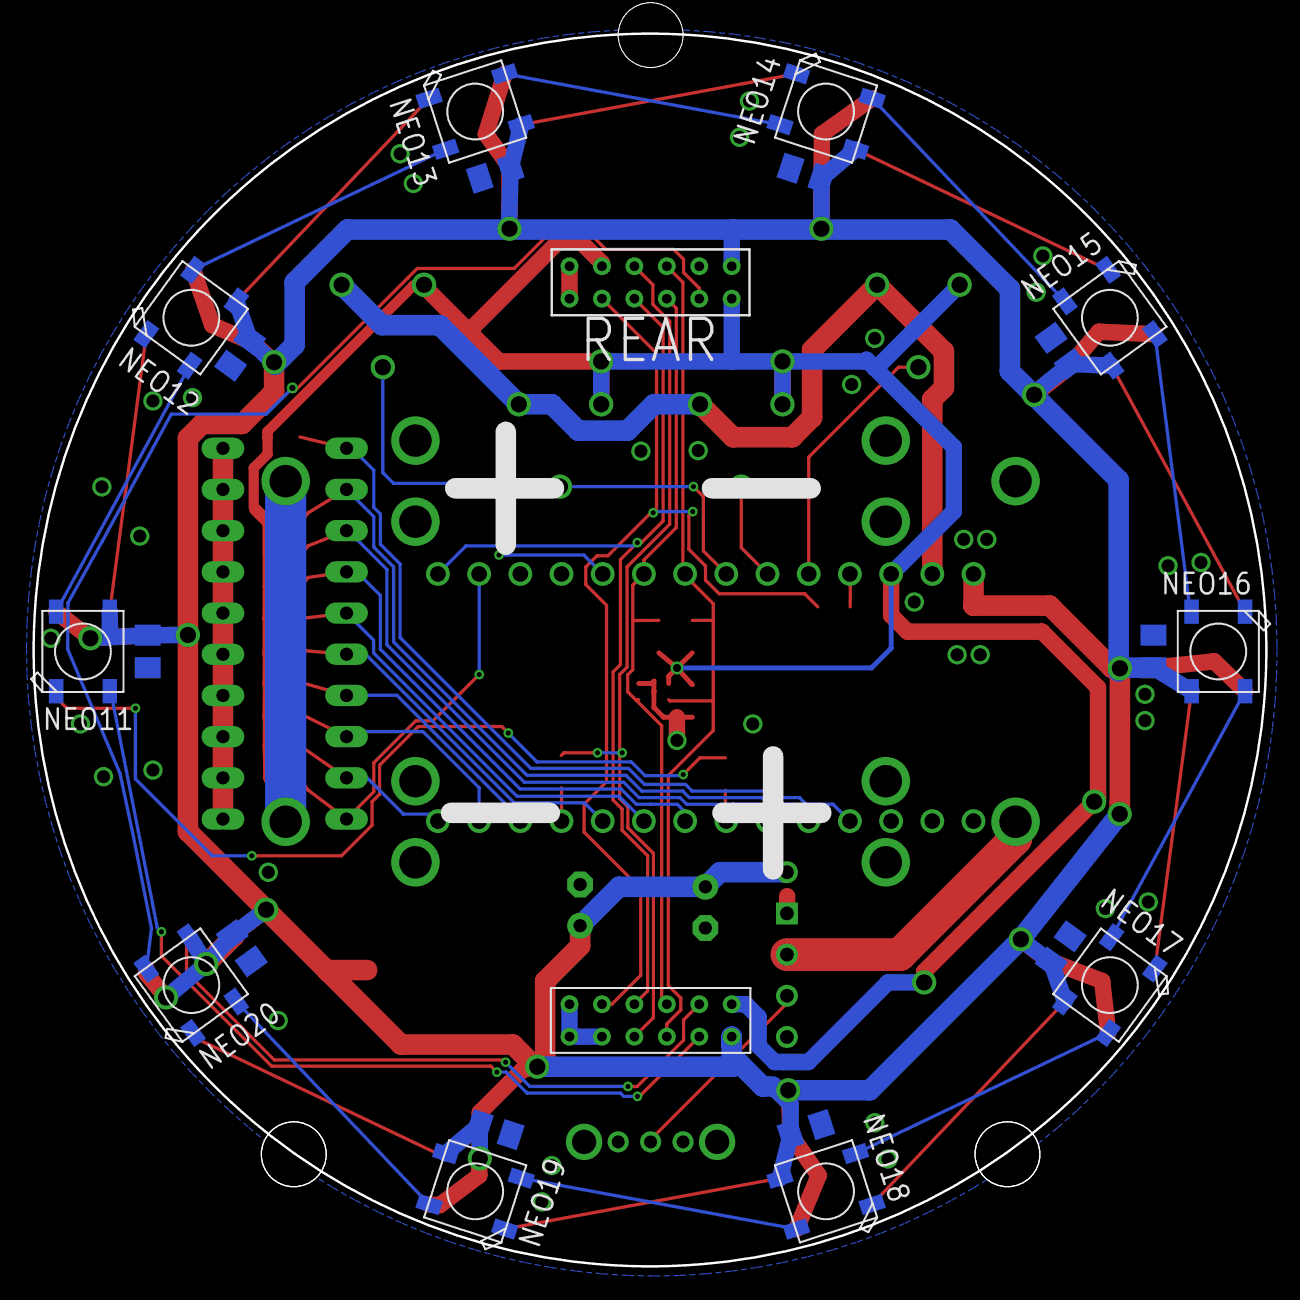
[picture p28: board moth_v3_80mm_main_board.brd from below]

Board: 2 copper layers, 76.0 x 76.0 mm, 72 parts (22 on the bottom side), 51 nets.
