nathanshaw/Moth/PCB/v3/54mm_breakout/moth_v3_54mm_breakout.brd

## EAGLE design PCB/v3/54mm_breakout/moth_v3_54mm_breakout.brd (2020-06-29)

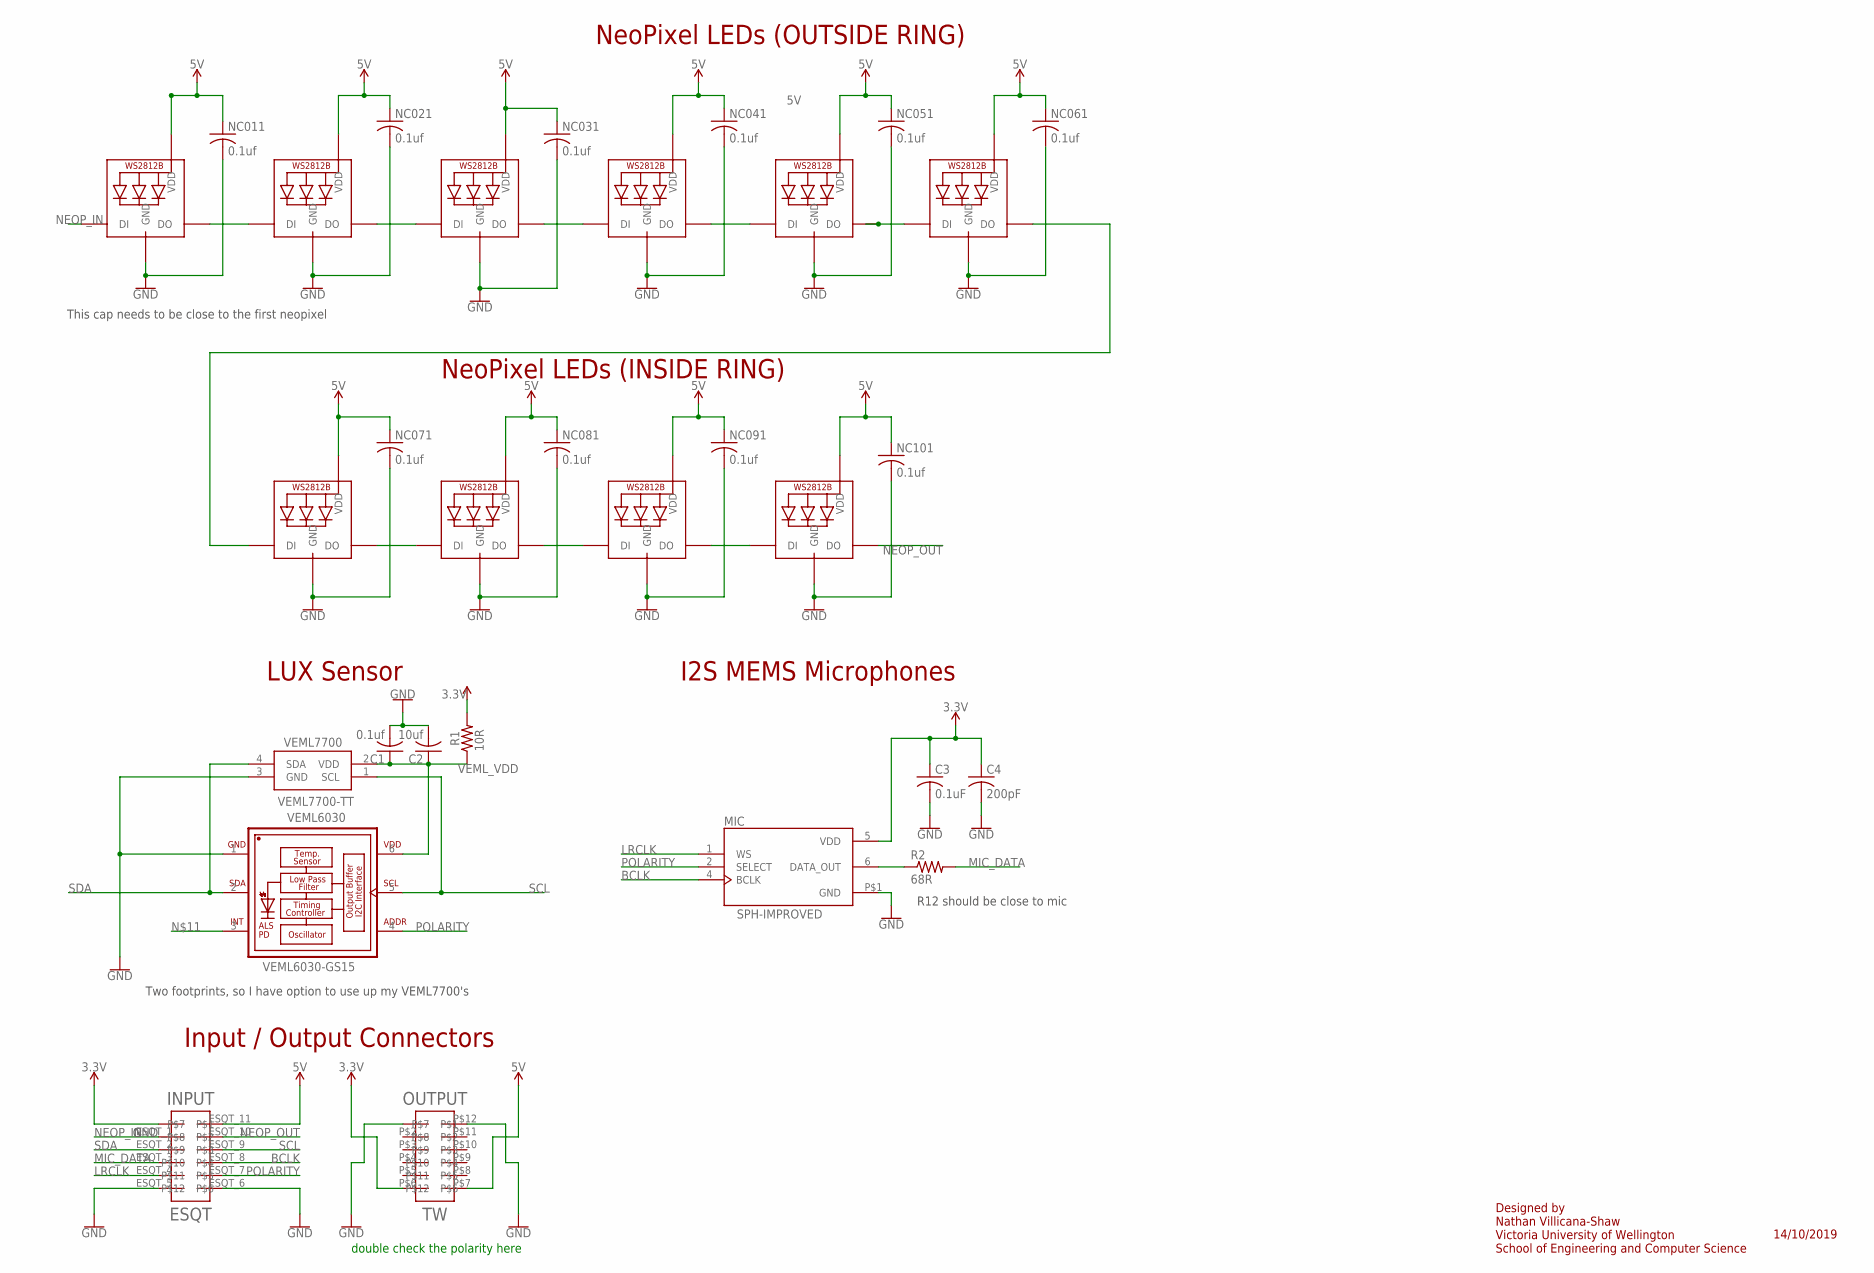
[picture p29: schematic moth_v3_54mm_breakout.sch]

Parts:
C1: 0.1uf; C0805
C2: 10uf; C0805
C3: 0.1uF; C0805
C4: 200pF; C0805
INPUT: ESQT; SAMTEC_ESQT_2X6_THROUGH_HOLE
MIC: SPH-IMPROVED; MIC_SPH0645LM4H-B_LARGER_RING
NC011, NC021, NC031, NC041, NC051, NC061, NC071, NC081, NC091, NC101: 0.1uf; C0805K
NEO1, NEO2, NEO3, NEO4, NEO5, NEO6, NEO07, NEO08, NEO9, NEO10: WS2812B5050; WS2812B
OUTPUT: TW; SAMTEC_TW_2X6
R1: 10R; R0805
R2: 68R; M0805
VEML6030: VEML6030-GS15; VISHAY_VEML6030_2X2X0.87
VEML7700: VEML7700-TT; VEML7700

Connections:
3.3V: C3.1, C4.1, INPUT.ESQT_0, MIC.5 (VDD), OUTPUT.P$6, R1.2
5V: INPUT.ESQT_11, NC011.1, NC021.1, NC031.1, NC041.1, NC051.1, NC061.1, NC071.1, NC081.1, NC091.1, NC101.1, NEO1.1-VDD (VDD), NEO2.1-VDD (VDD), NEO3.1-VDD (VDD), NEO4.1-VDD (VDD), NEO5.1-VDD (VDD), NEO6.1-VDD (VDD), NEO07.1-VDD (VDD), NEO08.1-VDD (VDD), NEO9.1-VDD (VDD), NEO10.1-VDD (VDD), OUTPUT.P$7
1232135: NEO08.2-DOUT (DO), NEO9.4-DIN (DI)
BCLK: INPUT.ESQT_8, MIC.4 (BCLK)
GND: C1.2, C2.2, C3.2, C4.2, INPUT.ESQT_5, INPUT.ESQT_6, MIC.P$1 (GND), NC011.2, NC021.2, NC031.2, NC041.2, NC051.2, NC061.2, NC071.2, NC081.2, NC091.2, NC101.2, NEO1.3-GND (GND), NEO2.3-GND (GND), NEO3.3-GND (GND), NEO4.3-GND (GND), NEO5.3-GND (GND), NEO6.3-GND (GND), NEO07.3-GND (GND), NEO08.3-GND (GND), NEO9.3-GND (GND), NEO10.3-GND (GND), OUTPUT.P$1, OUTPUT.P$12, VEML6030.1 (GND), VEML7700.3 (GND)
LRCLK: INPUT.ESQT_4, MIC.1 (WS)
MIC_DATA: INPUT.ESQT_3, R2.2
unnamed: NEO3.2-DOUT (DO), NEO4.4-DIN (DI)
unnamed: NEO4.2-DOUT (DO), NEO5.4-DIN (DI)
unnamed: NEO9.2-DOUT (DO), NEO10.4-DIN (DI)
unnamed: NEO07.2-DOUT (DO), NEO08.4-DIN (DI)
unnamed: NEO6.2-DOUT (DO), NEO07.4-DIN (DI)
unnamed: NEO5.2-DOUT (DO), NEO6.4-DIN (DI)
unnamed: NEO1.2-DOUT (DO), NEO2.4-DIN (DI)
unnamed: MIC.6 (DATA_OUT), R2.1
unnamed: NEO2.2-DOUT (DO), NEO3.4-DIN (DI)
NEOP_IN: INPUT.ESQT_1, NEO1.4-DIN (DI)
NEOP_OUT: INPUT.ESQT_10, NEO10.2-DOUT (DO)
POLARITY: INPUT.ESQT_7, MIC.2 (SELECT), VEML6030.4 (ADDR)
SCL: INPUT.ESQT_9, VEML6030.5 (SCL), VEML7700.1 (SCL)
SDA: INPUT.ESQT_2, VEML6030.2 (SDA), VEML7700.4 (SDA)
VEML_VDD: C1.1, C2.1, R1.1, VEML6030.6 (VDD), VEML7700.2 (VDD)

Notes on the sheet:
I2S MEMS Microphones
LUX Sensor
NeoPixel LEDs (OUTSIDE RING)
R12 should be close to mic
10R
Designed by Nathan Villicana-Shaw Victoria University of Wellington School of Engineering and Computer Science
14/10/2019
This cap needs to be close to the first neopixel
double check the polarity here
NeoPixel LEDs (INSIDE RING)
Input / Output Connectors
Two footprints, so I have option to use up my VEML7700's
