nathanshaw/Moth/PCB/v3/54mm_breakout/moth_v3_54mm_breakout.brd

## EAGLE design PCB/v3/54mm_breakout/moth_v3_54mm_breakout.brd (continued)

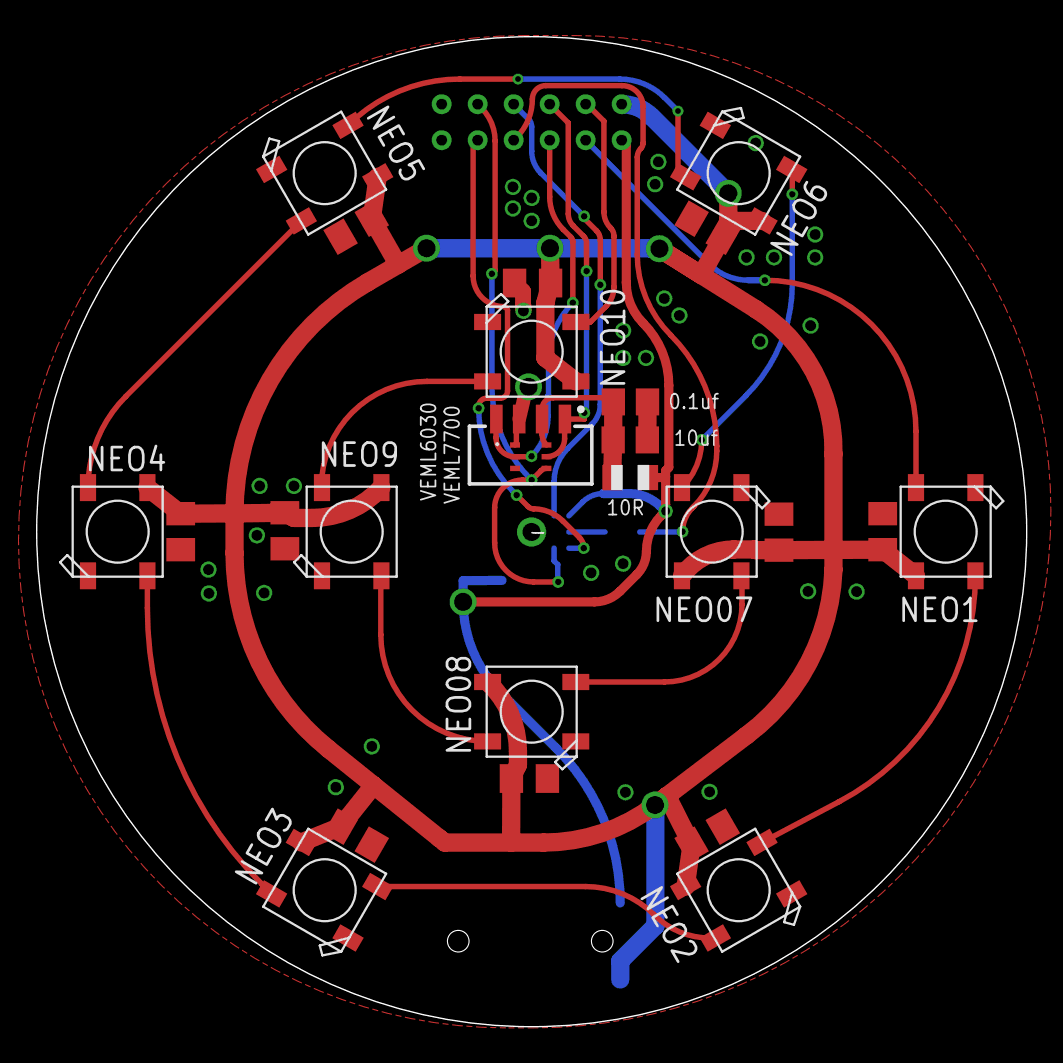
[picture p30: board moth_v3_54mm_breakout.brd from above]

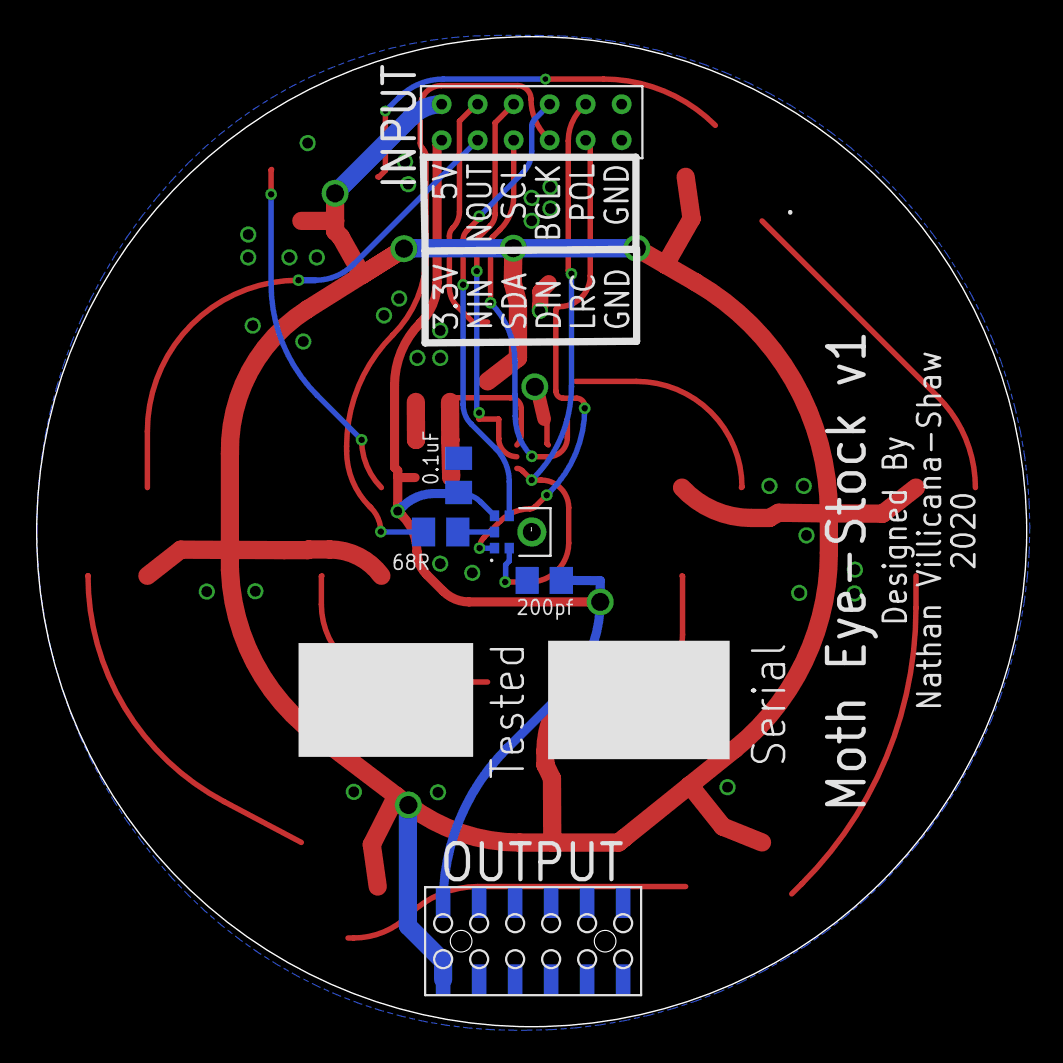
[picture p31: board moth_v3_54mm_breakout.brd from below]

Board: 2 copper layers, 55.0 x 55.0 mm, 31 parts (6 on the bottom side), 22 nets.
