nathanshaw/Moth/PCB/v1/moth_v1.brd

## EAGLE design PCB/v1/moth_v1.brd (2019-10-09, an earlier design)

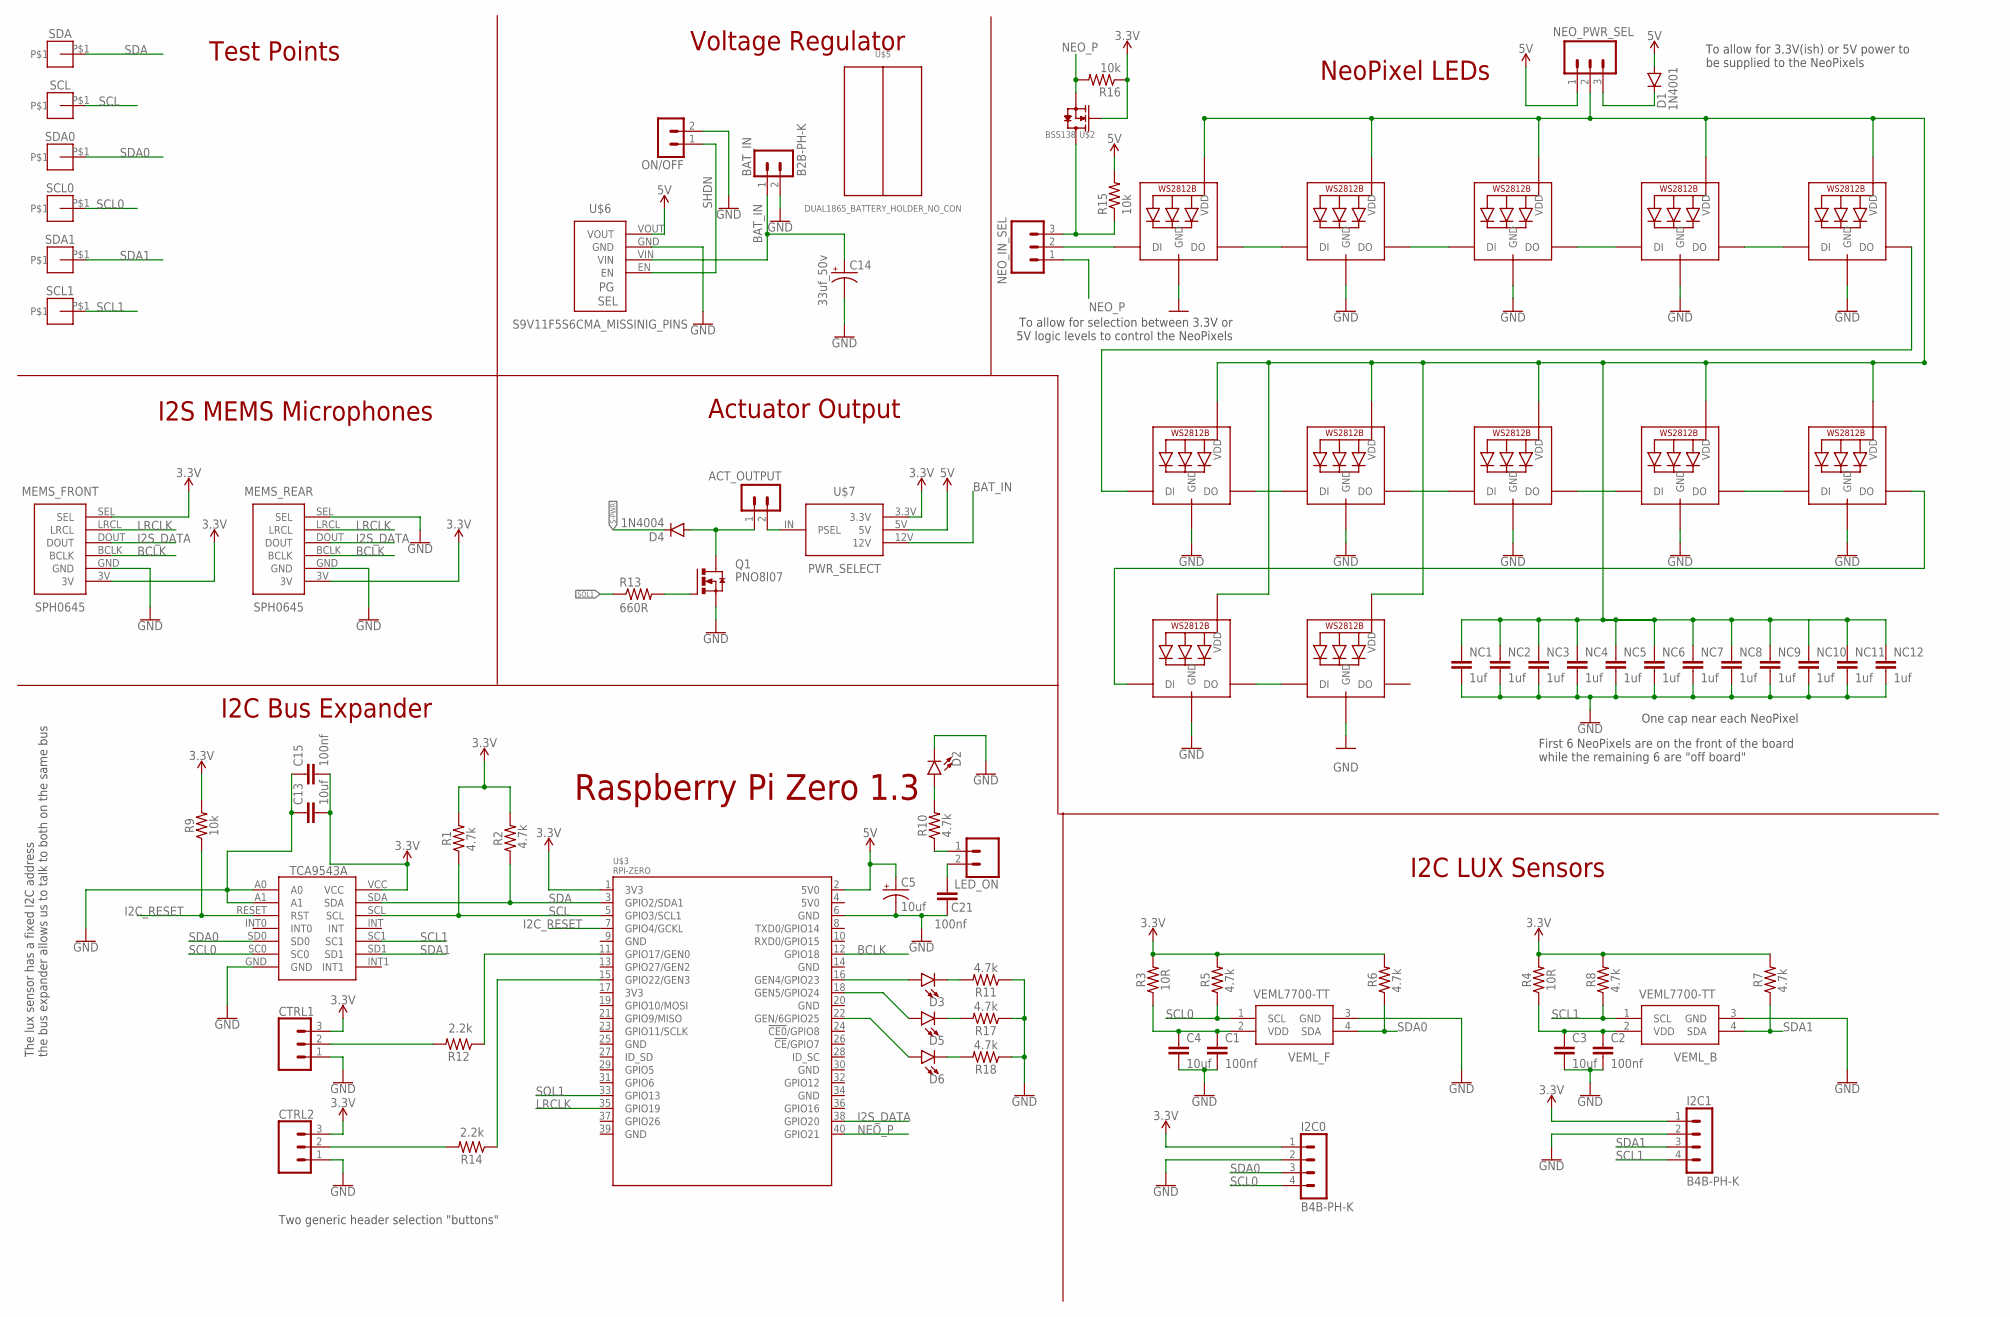
[picture p32: schematic moth_v1.sch]

Parts:
ACT_OUTPUT: B2B-PH-K
BAT_IN: B2B-PH-K
C1, C2, C15, C21: 100nf; 0603
C3, C4, C13: 10uf; 0603
C5: 10uf; E2,5-6
C14: 33uf_50v; E2-5
CTRL1, CTRL2: CONN_03; 1X03
D1: 1N4001; DIODE-1N4001
D2, D3, D5, D6: LED-FKIT-1206; FKIT-LED-1206
D4: 1N4004; DIODE-1N4001
I2C0, I2C1: B4B-PH-K
LED_ON: CONN_021X02_NO_SILK; 1X02_NO_SILK
MEMS_FRONT: SPH0645
MEMS_REAR: SPH0645
NC1, NC2, NC3, NC4, NC5, NC6, NC7, NC8, NC9, NC10, NC11, NC12: 1uf; 0603
NEO_01, NEO_02, NEO_03, NEO_04, NEO_05, NEO_06, NEO_07, NEO_08, NEO_09, NEO_10, NEO_11, NEO_12: WS2812B_5050N; WS2812B-NARROW
NEO_IN_SEL: CONN_03; 1X03
NEO_PWR_SEL: CONN_03; 1X03
ON/OFF: B2B-PH-K
Q1: PNO8l07; TO220BH
R1, R2, R5, R6, R7, R8: 4.7k; 0207/10
R3, R4: 10R; 0603
R9: 10k; 0207/10
R10, R11, R17, R18: 4.7k; 0603
R12, R14: 2k; 0207/10
R13: 660R; 0207/10
R15, R16: 10k; 0603
SCL, SCL0, SCL1: TEST_POINT_LARGE
SDA, SDA0, SDA1: TEST_POINT_LARGE
U$1: TCA9543A; SO14
U$2: BSS138; SOT23-3
U$3: RPI-ZERO; RASPBERRYPI_BASTELSTUBE_V13_RASPI_BOARD_B+_FULL
U$5: DUAL1865_BATTERY_HOLDER_NO_CON; DUAL_18650_BAT_HOLDER_NO_CON
U$6: S9V11F5S6CMA_MISSINIG_PINS; S9V11F3S5CMA_MISSING_PINS
U$7: PWR_SELECT; PWR_SELECT_PINOUT
VEML_B: VEML7700-TT; VEML7700
VEML_F: VEML7700-TT; VEML7700

Connections:
3.3V: C13.2, C15.2, CTRL1.3, CTRL2.3, I2C0.1, I2C1.1, MEMS_FRONT.3V, MEMS_FRONT.SEL, MEMS_REAR.3V, R1.2, R2.2, R3.2, R4.2, R5.2, R6.2, R7.2, R8.2, R9.2, R16.1, U$1.VCC, U$2.1 (G), U$3.1 (3V3), U$7.3.3V
5V: C5.+, D1.A, NEO_PWR_SEL.1, R15.2, U$3.2 (5V0), U$6.VOUT, U$7.5V
BAT_IN: BAT_IN.1, C14.+, U$6.VIN, U$7.12V
BCLK: MEMS_FRONT.BCLK, MEMS_REAR.BCLK, U$3.12 (GPIO18)
GND: BAT_IN.2, C1.2, C2.2, C3.2, C4.2, C5.-, C13.1, C14.-, C15.1, C21.1, CTRL1.1, CTRL2.1, D2.C, I2C0.2, I2C1.2, MEMS_FRONT.GND, MEMS_REAR.GND, MEMS_REAR.SEL, NC1.2, NC2.2, NC3.2, NC4.2, NC5.2, NC6.2, NC7.2, NC8.2, NC9.2, NC10.2, NC11.2, NC12.2, NEO_01.3-GND (GND), NEO_02.3-GND (GND), NEO_03.3-GND (GND), NEO_04.3-GND (GND), NEO_05.3-GND (GND), NEO_06.3-GND (GND), NEO_07.3-GND (GND), NEO_08.3-GND (GND), NEO_09.3-GND (GND), NEO_10.3-GND (GND), NEO_11.3-GND (GND), NEO_12.3-GND (GND), ON/OFF.2, Q1.S, R11.1, R17.1, R18.1, U$1.A0, U$1.A1, U$1.GND, U$3.6 (GND), U$6.GND, VEML_B.3 (GND), VEML_F.3 (GND)
I2C_RESET: R9.1, U$1.RESET (RST), U$3.7 (GPIO4/GCKL)
I2S_DATA: MEMS_FRONT.DOUT, MEMS_REAR.DOUT, U$3.38 (GPIO20)
LRCLK: MEMS_FRONT.LRCL, MEMS_REAR.LRCL, U$3.35 (GPIO19)
unnamed: C1.1, C4.1, R3.1, VEML_F.2 (VDD)
unnamed: C2.1, C3.1, R4.1, VEML_B.2 (VDD)
unnamed: R12.1, U$3.11 (GPIO17/GEN0)
unnamed: NEO_02.2-DOUT (DO), NEO_03.4-DIN (DI)
unnamed: NEO_05.2-DOUT (DO), NEO_06.4-DIN (DI)
unnamed: NEO_11.2-DOUT (DO), NEO_12.4-DIN (DI)
unnamed: NEO_04.2-DOUT (DO), NEO_05.4-DIN (DI)
unnamed: NC1.1, NC2.1, NC3.1, NC4.1, NC5.1, NC6.1, NC7.1, NC8.1, NC9.1, NC10.1, NC11.1, NC12.1, NEO_01.1-VDD (VDD), NEO_02.1-VDD (VDD), NEO_03.1-VDD (VDD), NEO_04.1-VDD (VDD), NEO_05.1-VDD (VDD), NEO_06.1-VDD (VDD), NEO_07.1-VDD (VDD), NEO_08.1-VDD (VDD), NEO_09.1-VDD (VDD), NEO_10.1-VDD (VDD), NEO_11.1-VDD (VDD), NEO_12.1-VDD (VDD), NEO_PWR_SEL.2
unnamed: NEO_03.2-DOUT (DO), NEO_04.4-DIN (DI)
unnamed: NEO_07.2-DOUT (DO), NEO_08.4-DIN (DI)
unnamed: NEO_08.2-DOUT (DO), NEO_09.4-DIN (DI)
unnamed: NEO_09.2-DOUT (DO), NEO_10.4-DIN (DI)
unnamed: NEO_10.2-DOUT (DO), NEO_11.4-DIN (DI)
unnamed: R14.1, U$3.15 (GPIO22/GEN3)
unnamed: D2.A, R10.2
unnamed: CTRL2.2, R14.2
unnamed: CTRL1.2, R12.2
unnamed: Q1.G, R13.2
unnamed: ACT_OUTPUT.1, D4.A, Q1.D
unnamed: NEO_06.2-DOUT (DO), NEO_07.4-DIN (DI)
unnamed: C21.2, LED_ON.2
unnamed: D1.C, NEO_PWR_SEL.3
unnamed: NEO_IN_SEL.3, R15.1, U$2.3 (D)
unnamed: LED_ON.1, R10.1
unnamed: D3.C, R11.2
unnamed: D5.C, R17.2
unnamed: D6.C, R18.2
unnamed: D3.A, U$3.16 (GEN4/GPIO23)
unnamed: D5.A, U$3.18 (GEN5/GPIO24)
unnamed: D6.A, U$3.22 (GEN/6GPIO25)
NEO_P: NEO_IN_SEL.1, R16.2, U$2.2 (S), U$3.40 (GPIO21)
NEO_P1: NEO_01.2-DOUT (DO), NEO_02.4-DIN (DI)
NEO_P99: NEO_01.4-DIN (DI), NEO_IN_SEL.2
S-PWR: ACT_OUTPUT.2, D4.C, U$7.IN (PSEL)
SCL: R1.1, SCL.P$1, U$1.SCL, U$3.5 (GPIO3/SCL1)
SCL0: I2C0.4, R5.1, SCL0.P$1, U$1.SC0, VEML_F.1 (SCL)
SCL1: I2C1.4, R8.1, SCL1.P$1, U$1.SC1, VEML_B.1 (SCL)
SDA: R2.1, SDA.P$1, U$1.SDA, U$3.3 (GPIO2/SDA1)
SDA0: I2C0.3, R6.1, SDA0.P$1, U$1.SD0, VEML_F.4 (SDA)
SDA1: I2C1.3, R7.1, SDA1.P$1, U$1.SD1, VEML_B.4 (SDA)
SHDN: ON/OFF.1, U$6.EN
SOL1: R13.1, U$3.33 (GPIO13)

Notes on the sheet:
I2S MEMS Microphones
Voltage Regulator
Actuator Output
Raspberry Pi Zero 1.3
I2C LUX Sensors
I2C Bus Expander
NeoPixel LEDs
10k
4.7k
2.2k
660R
One cap near each NeoPixel
To allow for 3.3V(ish) or 5V power to be supplied to the NeoPixels
To allow for selection between 3.3V or 5V logic levels to control the NeoPixels
First 6 NeoPixels are on the front of the board while the remaining 6 are "off board"
Two generic header selection "buttons"
The lux sensor has a fixed I2C address the bus expander allows us to talk to both on the same bus
Test Points

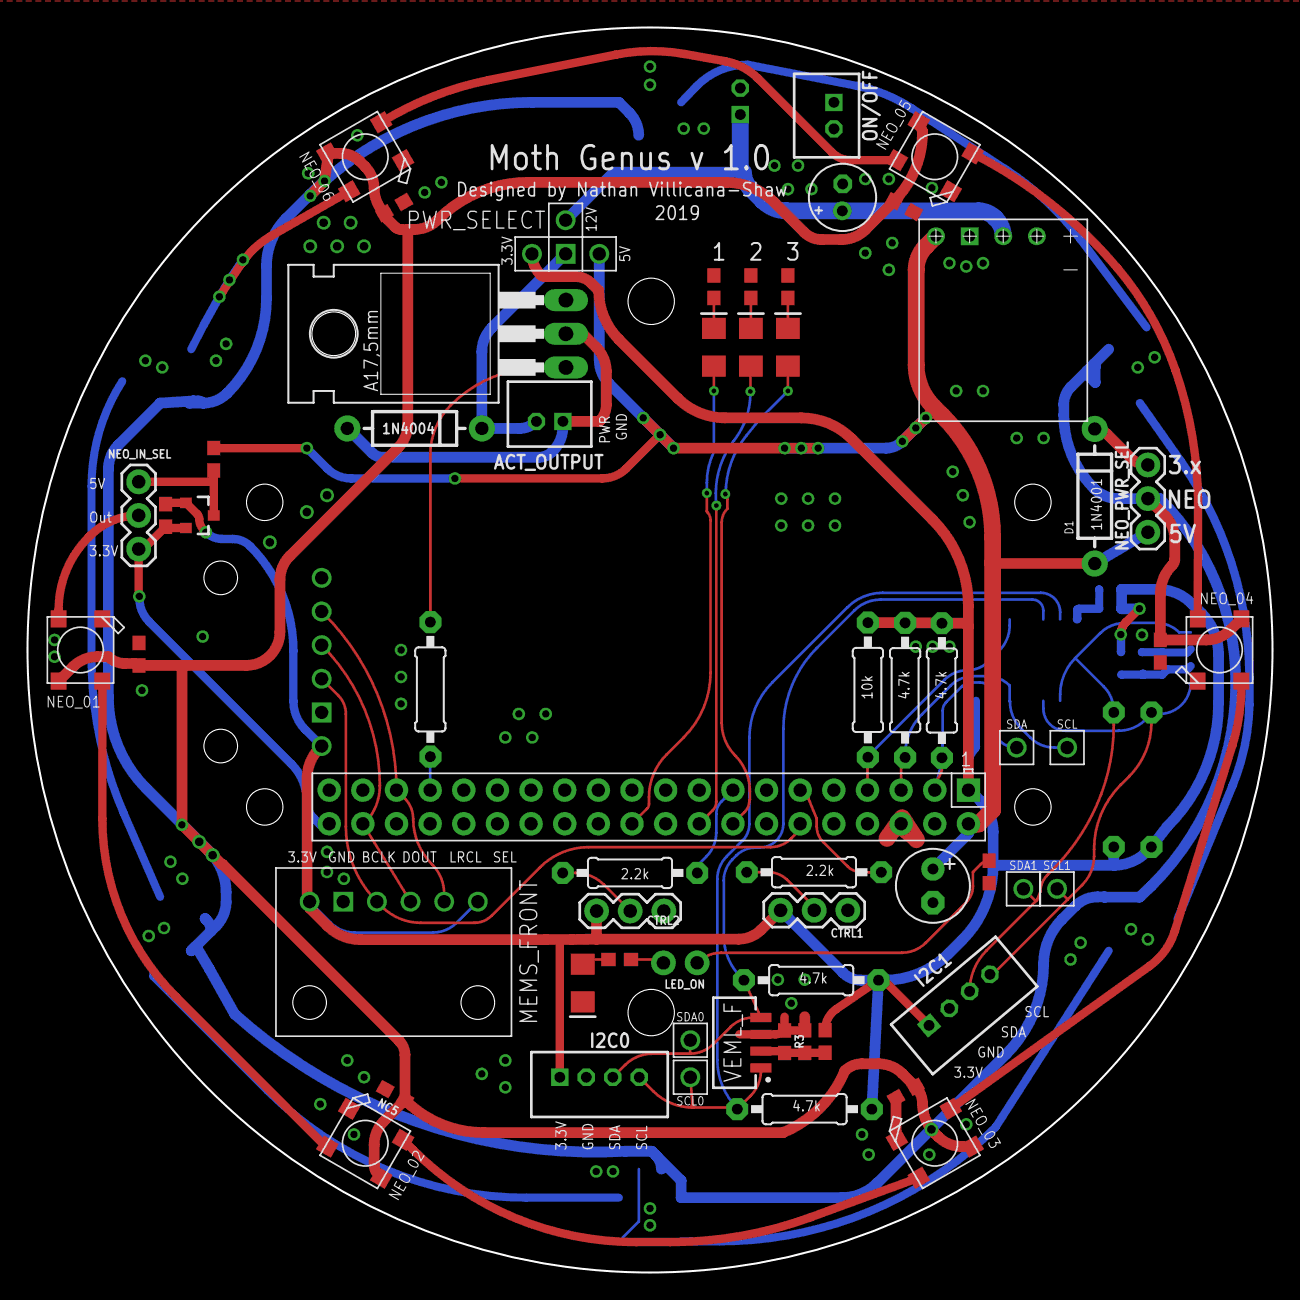
[picture p33: board moth_v1.brd from above]

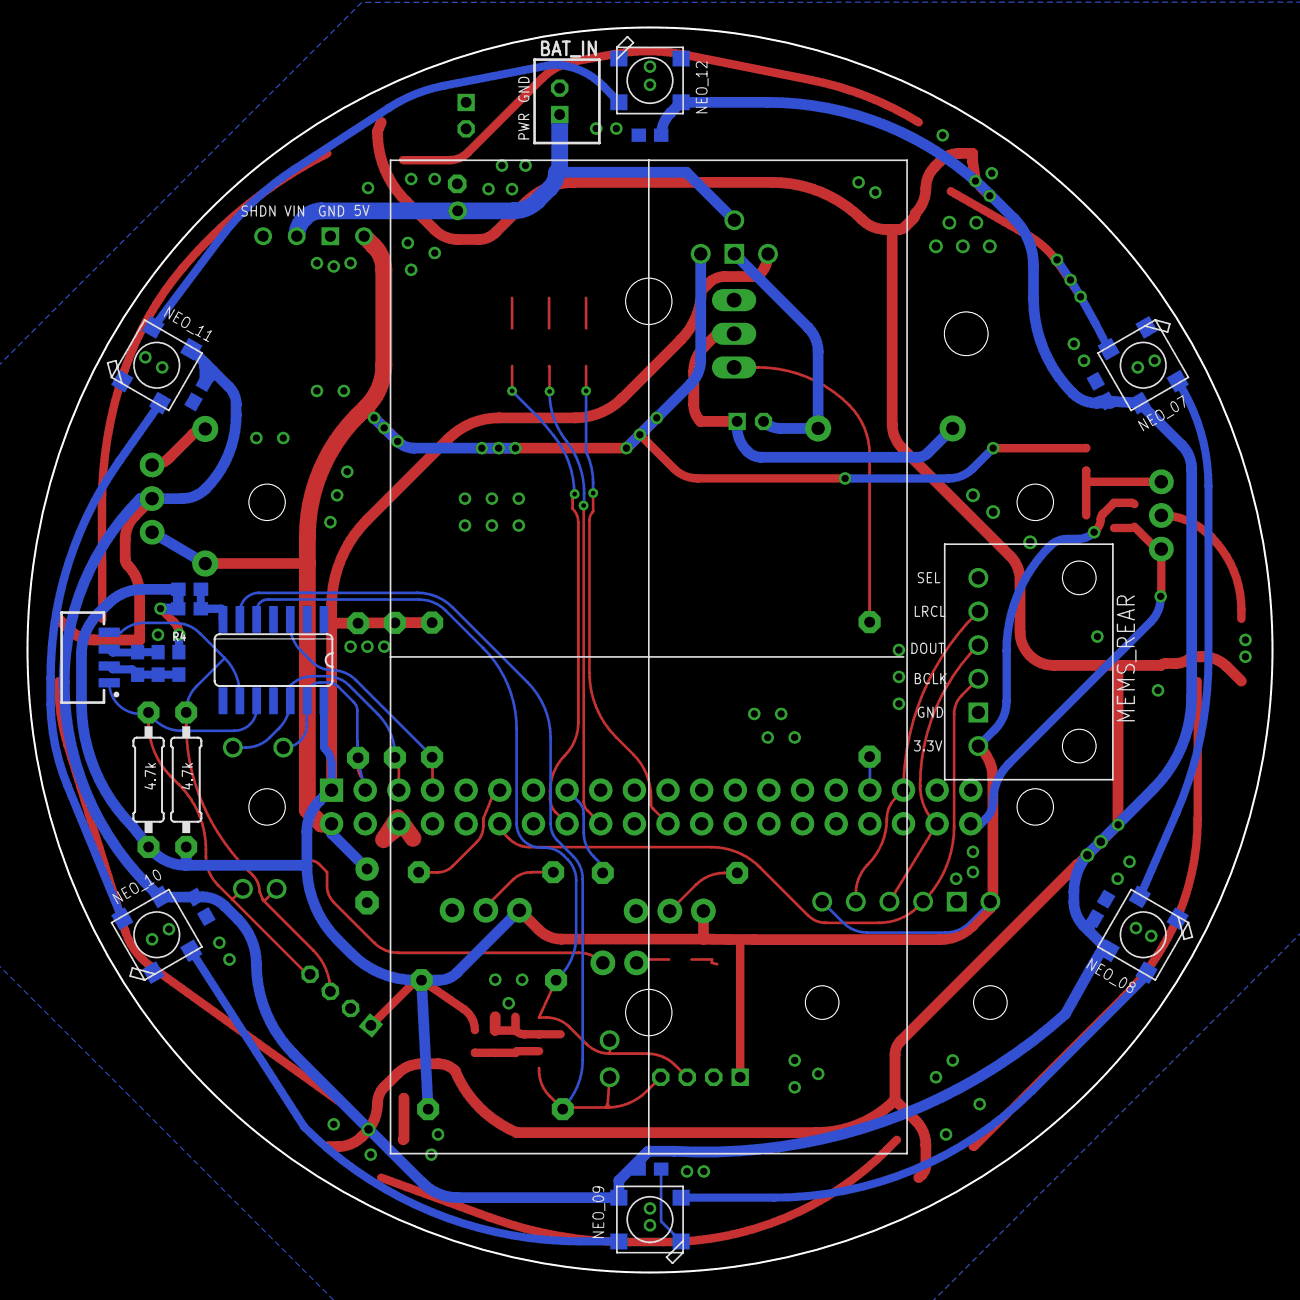
[picture p34: board moth_v1.brd from below]

Board: 2 copper layers, 94.0 x 94.0 mm, 84 parts (24 on the bottom side), 50 nets.
