nathanshaw/Moth/code/Speculator/Configuration_hardware.h

#ifndef __CONFIGURATION_ADV_H__
#define __CONFIGURATION_ADV_H__
// contains all the hardware specific variables
#define HARDWARE_NAME "Moth"
#include "PrintUtils.h"
#include "Macros.h"

// There are three artefact types currently availible 
// SPECULATOR, EXPLORATOR, and LEGATUS
#define ARTEFACT_TYPE             SPECULATOR
#define HV_MAJOR                  3
#define HV_MINOR                  0

// For the Speculator.....
// FIRMWARE MODE should be set to  CICADA_MODE, PITCH_MODE, or TEST_MODE
// depending on what functionality you want
#define FIRMWARE_MODE             PITCH_MODE

/////////////////////// Enclosure Type //////////////////////////////
// Currently there are four the Speculator enclosures: 
// GROUND_ENCLOSURE, ORB_ENCLOSURE_WITH_HOLE
// ORB_ENCLOSURE_WITHOUT_HOLE, and NO_ENCLOSURE
// if it is unknown what enclosure will be paired with the PCB
// it is recommended to map ENCLOSURE_TYPE to a physical switch
uint8_t ENCLOSURE_TYPE =          ORB_ENCLOSURE_WITHOUT_HOLE;

// different enclosures result in varying attenuation levels
// ENC_GAIN_ADJUST is automatically calculated based on
// the ARTEFACT_TYPE and ENCLOSURE_TYPE
#if ARTEFACT_TYPE == SPECULATOR
#if ENCLOSURE_TYPE == ORB_ENCLOSURE_WITH_HOLE
double ENC_GAIN_ADJUST =        1.0;
#elif ENCLOSURE_TYPE == ORB_ENCLOSURE_WITHOUT_HOLE
double ENC_GAIN_ADJUST =        2.0;
#elif ENCLOSURE_TYPE == GROUND_ENCLOSURE
double ENC_GAIN_ADJUST =        3.0;
#elif ENCLOSURE_TYPE == NO_ENCLOSURE
double ENC_GAIN_ADJUST =        0.75;
#endif // ENCLOSURE_TYPE
#endif // ARTEFACT_TYPE

//////////////////////////////////////////////////////////////////
/////////////////////// Enclosure Finish /////////////////////////
//////////////////////////////////////////////////////////////////
#define FINISH_NORMAL                  0
#define FINISH_FROSTED                 1

#define ENCLOSURE_FINISH               FINISH_NORMAL

#if ENCLOSURE_FINISH == FINISH_NORMAL
#define LUX_ENCLOSURE_SCALER           0.75
#elif ENCLOSURE_FINISH == FINISH_FROSTED
#define LUX_ENCLOSURE_SCALER           1.0
#endif 

////////////////////// Lux Sensors ///////////////////////////////////
#if HV_MAJOR > 1
#define NUM_LUX_SENSORS           2
#endif

// todo add logic to change these if needed...
#if (HV_MAJOR == 3)
#define NUM_LED                   40
#endif

#if (HV_MAJOR == 2 && HV_MINOR == 0)
#define NUM_LED                   12
#endif

#if (HV_MAJOR == 2 && HV_MINOR == 1)
#define NUM_LED                   10
#endif 

#define FRONT_MICROPHONE_INSTALLED      true
#define REAR_MICROPHONE_INSTALLED       true

////////////// TCA Bus Expanders     /////
// I2C_MULTI should be 0 if no TCA I2C bus expander is present on the PCB
// I2C MULTI should be 1 if a TCA I2C bus expander is present
#if HV_MAJOR < 3
#define I2C_MULTI                 1
// the number of active channels on the TCA (can in theory support 8 sensors, etc.)
#define TCA_CHANNELS              2
#else
#define I2C_MULTI                 0
#define TCA_CHANNELS              0 
#endif

//////////// MICROCONTROLLER PIN OUTS ////
#define LED_PIN                   5

///////////////////////////////////////////////////////////////////////////////////////
////////////////////////////// User Controls //////////////////////////////////////////
///////////////////////////////////////////////////////////////////////////////////////

// in ms, how often will theUI controls update?
#define UI_POLLING_RATE 60
// how much play will the pots have before returning a value?
// good values should range between 0.002 and 0.005
#define POT_PLAY        0.004

// should the UIManager print when the user control elements are changed?
#define P_UIMANAGER     true

#if HV_MAJOR < 3
#define NUM_JUMPERS               6

// pins for the buttons
#define BUT1_PIN                  12
#define BUT2_PIN                  11
#define BUT3_PIN                  14
#define BUT4_PIN                  15
#define BUT5_PIN                  16
#define BUT6_PIN                  17

#define BUT1_REVERSE              false
#define BUT2_REVERSE              false
#define BUT3_REVERSE              false
#define BUT4_REVERSE              false
#define BUT5_REVERSE              false
#define BUT6_REVERSE              false

#define BUT1_ACTIVE               true 
#define BUT2_ACTIVE               true
#define BUT3_ACTIVE               true
#define BUT4_ACTIVE               true
#define BUT5_ACTIVE               true
#define BUT6_ACTIVE               true

#define BUT1_PULLUP               false
#define BUT2_PULLUP               false
#define BUT3_PULLUP               false
#define BUT4_PULLUP               false
#define BUT5_PULLUP               false
#define BUT6_PULLUP               false

#define BUT1_NAME                 ""
#define BUT2_NAME                 ""
#define BUT3_NAME                 ""
#define BUT4_NAME                 ""
#define BUT5_NAME                 ""
#define BUT6_NAME                 ""

#define NUM_POTS                  0
int jmp_pins[NUM_JUMPERS] = {BUT1_PIN, BUT2_PIN, BUT3_PIN, BUT4_PIN, BUT5_PIN,
                             BUT6_PIN};

#define NUM_POTS                  0

#elif HV_MAJOR == 3
#define NUM_JUMPERS               10

#define BUT10_PIN                 14
#define BUT9_PIN                  12
#define BUT8_PIN                  11
#define BUT7_PIN                  10
#define BUT6_PIN                  8
#define BUT5_PIN                  7
#define BUT4_PIN                  6
#define BUT3_PIN                  4
#define BUT2_PIN                  3
#define BUT1_PIN                  2

int jmp_pins[NUM_JUMPERS] = {BUT1_PIN, BUT2_PIN, BUT3_PIN, BUT4_PIN, BUT5_PIN,
                             BUT6_PIN, BUT7_PIN, BUT8_PIN, BUT9_PIN, BUT10_PIN};

#define NUM_POTS                  4
#define POT1_PIN                  22
#define POT2_PIN                  21
#define POT3_PIN                  20
#define POT4_PIN                  17

int pot_pins[NUM_POTS] = {POT1_PIN, POT2_PIN, POT3_PIN, POT4_PIN};
uint16_t pot_vals[NUM_POTS] = {0, 0, 0, 0};

#endif

// TODO - need  to move some of this to the EEPROM storage, and add a flag in the standard configuratui file to  either read that information or to write it
// how long does the microphone test routine last for in the feature collector testMicrophone() function
#define MICROPHONE_TEST_DURATION  1500
#define LUX_TEST_DURATION         1000

////////////////////////////////////////////////////////////////////////////
///////////////////////// Jumper Settings //////////////////////////////////
////////////////////////////////////////////////////////////////////////////
// turn on/off reading jumpers in setup (if off take the default "true" values for jumper bools
#define JUMPERS_POPULATED               1

#endif // __HARDWARE_CONFIGURATION_H__
