nathanshaw/Moth/(commit log)

2019-09-10 added a teensy firmware file for using the audio library, as well as a .gitignore with DS_Store files added
2019-10-05 worked out some tests for possibly using the Teensy instead of the Pi for the project
2019-10-08 got a working rough version of the teensy_tests for moth working correctly
    [audio_amp_to_brightness.ino, firmware_main_test.ino, main_test.ino, neop_test.ino]
2019-10-09 added the cicada wav file, the PCB EAGLE files and a few teensy tests for the repo
    [moth_v1.brd, moth_v1.sch, moth_v2.brd, moth_v2.sch]
2019-10-09 got a working version of the VEML sensors working through the TCA9543A
    [moth_v2.brd, moth_v2.sch]
2019-10-10 new but untested auto_gain control also minor updates to the v2 PCB
    [moth_v2.brd, moth_v2.sch]
2019-10-15 finished the v2 PCB
    [moth_v2.brd, moth_v2.sch]
2019-10-28 added the final v2.1 of the PCB, updated the firmware to a place where it can handle stereo audio more or less and the use of both lux sensors
    [moth_v2.1.brd, moth_v2.1.sch]
2019-10-28 reworked the folder structure for the repo
    [audio_amp_to_brightness.ino, firmware_main_test.ino, main_test.ino, neop_test.ino]
2019-11-23 started a v3 of the code after working hard on a refactoring to move some parts out into libraries which can be used in other projects
    [Configuration.h, Configuration_adv.h]
2019-11-23 added a pdf of the v1 moth pcb
2019-11-25 creaded v3 of the code which is modular with the goal of being used on lyre and other bots
    [Configuration.h, Configuration_adv.h]
2019-11-26 code at v 3.0.3
    [Configuration.h, Configuration_adv.h]
2019-11-27 got a working version of the pitch mode added, now I am going to try and add its functionality to the main Moth code
    [Configuration.h]
2019-11-27 integrated the two modes into one program, dubbed it 3.1.0 =)
    [Configuration.h, Configuration_adv.h, Configuration_pitch.h]
2019-11-27 got a rough version of the hsb mapping working
    [Configuration.h, Configuration_adv.h, Configuration_pitch.h]
2019-12-02 working more on the refactor, things are broken at the momemt, working on rebuilding the datalogging library better
    [Configuration.h, Configuration_adv.h, Configuration_cicadas.h, Configuration_pitch.h]
2019-12-02 working version of the code, the datalogging is not implemented, but the original code works with parts of the datalogging code added, or at least in the cicada mode
    [Configuration.h]
2019-12-03 got another working version of the code with a little more o f the datalog working
    [Configuration.h, Configuration_adv.h]
2019-12-04 check point where both the setup config logging and the continious datalogging both work
    [Configuration.h, Configuration_adv.h]
2019-12-04 tested with multiple over-time and once-off logs, everything looks good
    [Configuration.h]
2019-12-04 moved some things around
    [Configuration.h, Configuration_adv.h, Configuration_cicadas.h, Configuration_pitch.h]
2019-12-05 moved software to v 3.1.2, seems to be mostly working like before in cicadaMode
    [Configuration.h, Configuration_adv.h]
2019-12-05 got 3.1.2 working wellish, got rid of the configuration_adv file, made the current configuration file look much nicer and have better organisation
    [Configuration.h, Configuration_adv.h, Configuration_cicadas.h, Configuration_pitch.h]
2019-12-05 fixed the clicks so they work now, the cicadaMode is more or less back to normal, updated the software version to 3.2.0
    [Configuration.h, Configuration_cicadas.h]
2019-12-05 removed extra print statement
    [Configuration.h]
2019-12-05 got the datalogging working even better, fixed a bug or two, made the print out better, etc, moving the program version up to 3.2.1
    [Configuration.h]
2019-12-06 got the auto-gain more or less working now as it was before =)
    [Configuration.h, Configuration_cicadas.h]
2019-12-07 everything is broken, moved changes to new branch
    [Configuration.h, Configuration_adv.h, Configuration_cicadas.h, Configuration_pitch.h]
2019-12-07 still crap
    [Configuration.h, Configuration_cicadas.h, Configuration_pitch.h]
2019-12-08 cicada mode working again, haha, pitch is still not so hunky
    [Configuration.h, Configuration_adv.h, Configuration_pitch.h]
2019-12-10 fixed some bugs with how static logs are handled, current configuration is for the battery tests
    [Configuration.h, Configuration_adv.h]
2019-12-10 got both a rough pitch and a rough cicada mode working on the same code, YAY
    [Configuration.h, Configuration_pitch.h]
2019-12-12 working a little more on the refactor
    [Configuration.h, Configuration_pitch.h]
2019-12-13 added datalogging for RGB average avlues, added tracking of RGB average vals to NeoManager, cleaned up the neomanager file a bit
    [Configuration.h, Configuration_adv.h]
2019-12-13 updated the template file for the creation of new modes, and started with the creation of the new test mode?
    [Configuration.h]
2019-12-18 middle of post-field test adjustments
    [Configuration.h, Configuration_adv.h, Configuration_cicadas.h]
2019-12-18 improved the field test mode to be a little easier to work with
    [Configuration.h]
2019-12-18 got stable version of test, pitch and cicada all working, upgraded the version number to 0.0.3
    [Configuration.h, Configuration_adv.h]
2019-12-18 fixed the non-independent flash option
    [Configuration.h, Configuration_adv.h]
2019-12-19 added a quicker polling time for the lux sensor when extreme lux conditions are present, tested and confirmed that extreme lux condition logic works when the brightness scalers are independent
    [Configuration.h, Configuration_cicadas.h]
2019-12-19 extreme lux working with combined lux as well =)
    [Configuration.h]
2020-02-03 few minor configuration changes
    [Configuration.h]
2020-02-05 Added in a low threshold for the song features
    [Configuration.h, Configuration_cicadas.h]
2020-02-05 added an enclosure type flag in the firmware, made it so the enclosure type ensures that the rear leds do not go off if the enclosure type is ground_enclosure
    [Configuration.h, Configuration_adv.h]
2020-02-05 added back a light yellow colour when the Moth is booting up
    [Configuration.h, Configuration_adv.h]
2020-02-13 moving on to pitch now
    [Configuration.h, Configuration_adv.h, Configuration_cicadas.h]
2020-02-14 got a basic version of the color to pitch mapping working with the Moth cicada mode
    [Configuration.h]
2020-02-17 reworking the feature collectors, started a v3 for the PCB
    [Configuration.h, Configuration_adv.h, Configuration_cicadas.h]
2020-02-20 moved to v0.0.5
    [Configuration.h, Configuration_adv.h, Configuration_cicadas.h]
2020-02-23 moving forward, sort of
    [Configuration.h, Configuration_adv.h, Configuration_cicadas.h]
2020-02-23 got the song more or less fixed, now have an issue with the clicks going crazy
    [Configuration.h, Configuration_cicadas.h]
2020-02-23 the brightness is fixed and now it scales locally so it should do a better job dealing with its dynamic range =)
    [Configuration.h]
2020-02-24 got a working more responsive, to a degree version of the code working
    [Configuration.h, Configuration_cicadas.h]
2020-02-24 moved to version 0.1.0 as the song seems to be working pretty well.
    [Configuration.h, Configuration_adv.h, Configuration_cicadas.h]
2020-02-27 added in jumpers for minor gain boost and the boot delay timer
    [Configuration.h, Configuration_adv.h]
2020-02-28 finally got a working version of newsong together
    [Configuration.h, Configuration_adv.h, Configuration_cicada_new.h]
2020-02-29 version 0.2.0
    [Configuration.h, Configuration_adv.h, Configuration_cicada_new.h]
2020-03-01 confirmed that this version of the code works well for cicada song
    [Configuration.h, Configuration_cicada.h, Configuration_cicada_new.h]
2020-03-04 getting rid of audio engine and neop manager to then add them as submodules
    [Configuration.h, Configuration_adv.h, Configuration_cicada.h, Configuration_datalogging.h, Configuration_hardware.h]
2020-03-13 minor changes
    [Configuration.h]
2020-03-14 got the LuxManager handeling both sensors and reporting a global lux based on the highest value between the sensors
    [Configuration.h, Configuration_datalogging.h]
2020-04-23 updated the PCB's with the definitive third version
    [moth_v3.0.brd, moth_v3.0.sch, moth_v3_54mm_breakout.brd, moth_v3_54mm_breakout.sch, moth_v3_60mm_v3.0.brd, moth_v3_60mm_v3.0.sch, moth_v3_80mm_main_board.brd, moth_v3_80mm_main_board.sch]
2020-04-23 moving to updating the code for the third version
    [Configuration.h, Configuration_cicada.h]
2020-05-06 updated the breakout board
    [moth_v3_54mm_breakout.brd]
2020-06-07 working on a version of the code which works well with the new hardware
    [Configuration.h, Configuration_hardware.h]
2020-06-29 got the Cicada code for PCB v2.1 working again, PCB v3 is still not really supported
    [Configuration.h, Configuration_cicada.h, Configuration_hardware.h]
2020-06-29 minor changes to the v3 breakout and main board
    [moth_v3_54mm_breakout.brd, moth_v3_80mm_main_board.brd]
2020-06-30 got v 0.2.2 up and running, 29 FPS, support for PCB 2.1 and 3.0, support for VEML6030's, slightly improved user commands, fixed issue with LTO compiling causing everything to crash a minute or two in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
    [Configuration.h, Configuration_cicada.h, Configuration_hardware.h]
2020-07-02 added a first version of center out mapping for PCB v3
    [Configuration.h]
2020-07-09 changed PRINT_ to P_, and made it so the first pot controls a master master brightness scaler
    [Configuration.h, Configuration_datalogging.h, Configuration_hardware.h, Configuration_pitch.h]
2020-07-11 v0.0.3 in reaction to thee field expedition, added threshold control for the click thresholds using the 4th pot, switched around some of the user controls, a splt was made in thee functionality of th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
    [Configuration.h, Configuration_cicada.h, Configuration_datalogging.h, Configuration_hardware.h]
2020-07-26 just after getting PC back, getting ready for general purpose pitch mode testing
    [Configuration.h]
2020-07-27 added a few print modes, cleaned up some things, fixed a few typos
    [Configuration.h]
2020-07-28 got a working good version of th ecode (more or less) working for v2.1 on pitch mode, just perhaps needs more gain
    [Configuration.h]
2020-07-28 pushed v0.2.5
    [Configuration.h, Configuration_hardware.h]
2020-08-10 updated the .gitignore and attributes, tring to change the name of the repo and everything from Moth to Speculator
    [Configuration.h, Configuration_datalogging.h, Configuration_hardware.h]
2020-08-10 added updates to the audio_engine
    [Configuration.h, Configuration_datalogging.h, Configuration_hardware.h]
2020-08-10 increased the audio memory from 16 to 24, this can officially be called the commit for v0.3.0, the major issue which needs to be addressed is theunknown memory leakage issue which causes the sketch t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
    [Configuration.h]
2020-08-10 isolated the restart issue... it is when the auto-gain manager runs its update...
    [Configuration.h]
2020-08-15 getting ready for computer reboot
    [moth_v3_80mm_main_board.sch]
2020-09-08 moved the luxmanager and neopixelmanager into their own Arduino libraries and out of the repo
    [Configuration.h]
2020-09-16 updated most images of the layout for the purpose of the thesis
    [moth_v2.1.brd, moth_v2.1.sch]
2020-09-21 working on updating code to mirror writing in thesis proper
    [Configuration_hardware.h]
2020-09-23 removed the colorconverter and the audioengine libraries from the main code
    [Configuration_hardware.h]
2020-09-26 moved firmware to v0.4.0 a stable version for pitch (more or less)
    [Configuration.h, Configuration_hardware.h]
2020-09-26 moved the lbs functionality into a file and then moved that file to legacy as the ValueTracker class now plays that role.
    [Configuration.h]
2020-09-27 software version 0.4.4
    [Configuration.h, Configuration_hardware.h]
2020-09-27 v0.4.5. --- loading firmware and then installing
    [Configuration.h]
