nathanshaw/Moth/(notices)

Notices in the files:
parts and their libraries:
SparkFun-PowerSymbols: Licensing: Creative Commons ShareAlike 4.0 International - https://creativecommons.org/licenses/by-sa/4.0
con-jst-ph: Copyright (C) 2016, Bob Starr
